onurefe/Lattice/v1.3/Hardware/Visuals/WaveUltrasonics-front.png

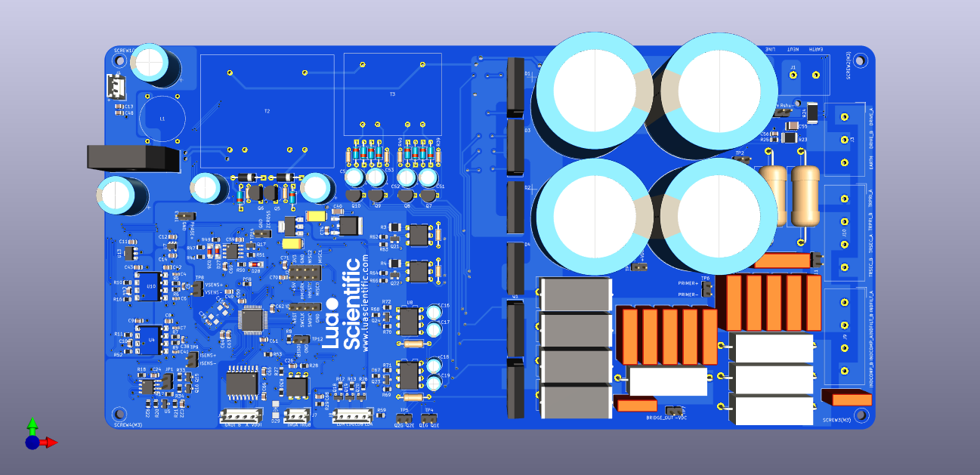
v1.3/Hardware/Visuals/WaveUltrasonics-front.png
