onurefe/Lattice/Documents/lattice.pdf

# Piezoelectric Control

Onur Efe

July 2020

## 1 Obtaining linear phase control measure

Impedance of the series rlc element can be given as;

Z = r + jwl +

1
jwc

=

jwrc − w

2
lc + 1
jwc
(1)

Since multiplicative inverse of the impedance Z is proportional to complex power, real power should be proportional to the real part of 1
Z

. According to
this normalized complex power p is introduced as;

p =

1
Z

=

jwc
jwrc − w²lc + 1
(2)

Normalized real power can be calculated as;

pr = <

jwc

(1 − w²lc) + jwrc
= <
jwc((1 − w

2
lc) − jwrc)
(1 − w²lc)

2 + (wrc)

2

= <

((jwc − jw³

lc²
) − j

2w

2

rc²
)
(1 − w²lc)

2 + (wrc)

2

=

w

2

rc²
(1 − w²lc)

2 + (wrc)

2

=

w

2

rc²
w⁴l

2c

2 − 2w²lc + w²r

2c

2 + 1

=

w

2

rc²
w⁴l

2c

2 + w²(r

2c

2 − 2lc) + 1 (3)

Expression isn’t suitable for linearization. But pimg
pr

can be a much more
suitable measure;

pimg
pr

=

wc−w

3

lc²
(1−w²lc)

2+(wrc)

2 −

1
wcp
w²rc²
(1−w²lc)

2+(wrc)

2

=

wc − w

3

lc²
w²rc²

−

(1 − w

2
lc)

2 + (wrc)

2
w³rc²cp

=

1 − w

2
lc
wrc

−

(1 − w

2
lc)

2 + (wrc)

2
w³rc²cp

(4)

1

Adding the normalized reactive power consumed by capacitance;

1 − w

2
lc −

1
wcp
wrc

(5)

Introducing quality factor which is defined defined as;

q =

1
r

r
l
c

(6)

And w0 is defined as;

w0 =

1
√
lc

(7)

Now variations of the load can be obtained from the variations of the resistance. Since the piezoelectric elements are pretty stable we can assume that l, c doesn’t change with loading; only r changes. Variables with subscript 0, 1 denoting values before and after loading respectively;

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
So when loaded, since the quality factor decreases, resistance will increase proportionally. So, in general, measuring complex impedance would give the resistance value as well; so data wheter the system is loaded or not can be obtained in very high rates.
Advantage of this method is there aren’t any dependence of any other process and control doesn’t interact with other controls.

## 2 Obtaining parallel capacitance

I = Icap + Irlc =

V
jwcp

+

jV wc
jwrc − w²lc + 1
V (jwrc − w

2
lc + 1)
(jwrc − w²lc + 1).(jwcp)

+

(jV wc).(jwcp)
(jwcp).(jwrc − w²lc + 1)

=

−V w²
ccp + V (jwrc − w

2
lc + 1)
−w²rccp − jw³lccp + jwcp

=

V (jwrc − w

2
lc + 1 − w

2
ccp)
−w²rccp − jw³lccp + jwcp

=⇒ Z =

−w

2

rccp − jw³
lccp + jwcp
jwrc − w²lc + 1 − w²ccp

(9)

Another way of obtaining the equivalent circuit model could be to use Taylor approximation applied to the impedance polynomial.

2

## 3 Power control with varying duty cycle

Components of the Fourier series of a pulse wave;

an =

2A
nπ
sin (nπd) | (10)

V, d denoting the amplitude of the pulse wave applied and duty cycle respectively, average power transmitted to the piezo device(considering that the first harmonic does match with the resonance frequency of the piezo device) does equal to;

Pdrv =

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
sin²

(πd) = 2A²
π

2r

1 − cos(2πd)
2

=

A²
π

2r

(1 − cos(2πd))

=⇒ 1 −

Pdrvπ

2
r
A²

= cos(2πd) =⇒ d =

1
2π

cos⁻¹
(1 −

Pdrvπ

2
r
A²

) (11)

Pdrvmax =

2A

2
π²r

. Now introducing normalized power Pnorm =

Pdrv
Pdrvmax

we
can express (??) as;

d =

1
2π

cos⁻¹
(1 − 2Pnorm) | (12)

Now introducing an approximation for cos⁻¹ (x);

cos⁻¹

(x) = π
2

+

x(a + bx²
)
1 + x

2(c + dx²)

(13)

where;

a
b
c
d

=

−0.939115566365855
0.9217841528914573
−1.2845906244690837
0.295624144969963174

(14)

## 4 Resonance Frequency Tracking Algorithm

Secant method like method will be used for resonance frequency tracking. Measure m =

pimg
pr

will be tried to make zero. mi

, fi denoting i.th measure and the frequency at iteration i, fi+1 is;

fi+1 = fi −

mi(fi − fi−1)

mi − mi−1

(15)

There should be some error about frequency shifting.

3
