onurefe/Lattice/v1.3/Hardware/Visuals/WaveUltrasonics-back.png

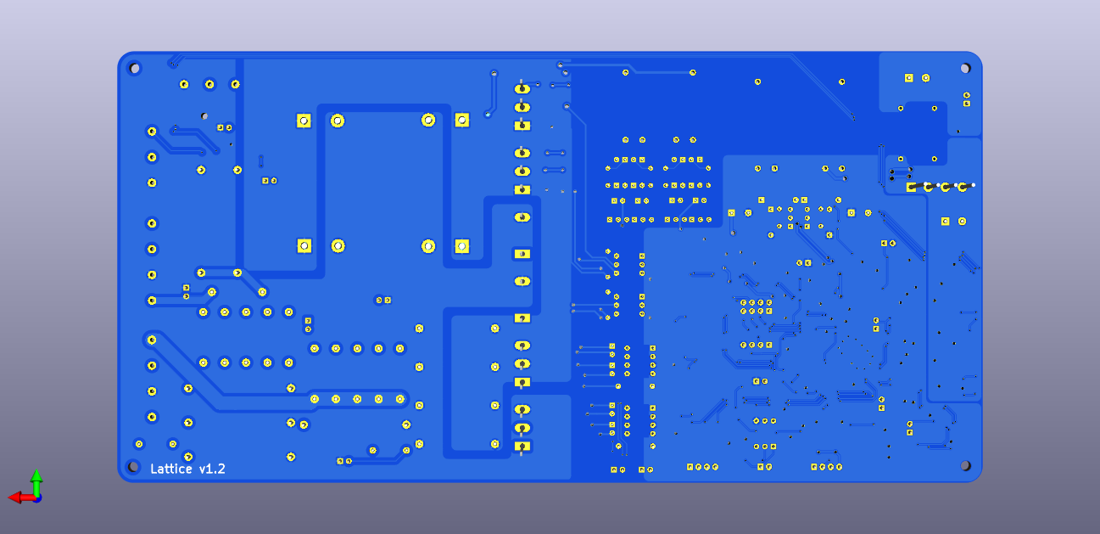
v1.3/Hardware/Visuals/WaveUltrasonics-back.png
