onurefe/Lattice/v1.3/Hardware/BOM v1.3.xlsx

Component(s) | Value | Link | Price | Quantity
> C1-C3, C69 | 470u 400v | https://ozdisan.com/passive-components/capacitors/aluminum-capacitors/K054004710PM0E050 | 3.43 USD | 4 | 13.73 USD
> C5, C38 | 33n %5 | https://ozdisan.com/passive-components/capacitors/smt-smd-and-mlcc-capacitors/CL21B333JBANNNC | 0.03 USD | 2 | 0.05 USD
> C4, C6, C7, C41 | 1n %5 | https://ozdisan.com/passive-components/capacitors/smt-smd-and-mlcc-capacitors/CL21C102JBCNNNC | 0.02 USD | 4 | 0.06 USD
> C11, C12, C14, C63 | 1u | https://ozdisan.com/passive-components/capacitors/smt-smd-and-mlcc-capacitors/CL21B105KBFNNNE | 0.02 USD | 4 | 0.09 USD
> C16-C19 | 2.2u 50v | https://ozdisan.com/passive-components/capacitors/smt-smd-and-mlcc-capacitors/CL21A225KBQNNNE | 0.06 USD | 4 | 0.24 USD
> C20, C21, C36, C37 | 820n 400VDC | https://ozdisan.com/passive-components/capacitors/film-capacitors/TMCF03-824K400VP22-5B | 0.11 USD | 4 | 0.44 USD
C23 | 1.5n 400VAC | https://ozdisan.com/passive-components/capacitors/film-capacitors/C323C152J60A605 | 0.12 USD | 1 | 0.12 USD
> C27, C29, C31 | 10nF 1600VDC | https://ozdisan.com/passive-components/capacitors/film-capacitors/C323C103J60A605 | 0.17 USD | 3 | 0.50 USD
> C22, C28, C30 | 22nF 2000VDC | https://ozdisan.com/passive-components/capacitors/film-capacitors/C84V1223J90C000 | 0.51 USD | 3 | 1.54 USD
C35 | 1000u 25v | https://ozdisan.com/passive-components/capacitors/aluminum-capacitors/PKR1-025V102MG160-TA5-0 | 0.09 USD | 1 | 0.09 USD
> C15, C39 | 18p | https://ozdisan.com/passive-components/capacitors/smt-smd-and-mlcc-capacitors/CL10C180JB8NNNC | 0.01 USD | 2 | 0.01 USD
C40 | 1uF 35v | https://ozdisan.com/passive-components/capacitors/tantalum-capacitors/T491A105K035AT | 0.10 USD | 1 | 0.10 USD
> C8, C9, C13, C24, C26, C32-C34, C42, C43, C49, C50, C61, C62, C64, C65, C68, C74 | 100n | https://ozdisan.com/passive-components/capacitors/smt-smd-and-mlcc-capacitors/CL21B104KBFWPNE | 0.02 USD | 18 | 0.28 USD
> C10, C44 | 47n %5 | https://ozdisan.com/passive-components/capacitors/smt-smd-and-mlcc-capacitors/CL31B473JBCNNNC | 0.04 USD | 2 | 0.08 USD
C47 | 2200u 25v | https://ozdisan.com/passive-components/capacitors/aluminum-capacitors/PKLH-025V222MI220-TA5-0 | 0.26 USD | 1 | 0.26 USD
> C51-C54 | 220u | https://ozdisan.com/passive-components/capacitors/aluminum-capacitors/PKR1-025V221ME110-T2-5 | 0.03 USD | 4 | 0.11 USD
C55 | 100p | https://ozdisan.com/passive-components/capacitors/smt-smd-and-mlcc-capacitors/C1210C101KGRAC7800 | 0.31 USD | 1 | 0.31 USD
C56 | 680n | https://ozdisan.com/passive-components/capacitors/smt-smd-and-mlcc-capacitors/CL21B684KOFNNNE | 0.03 USD | 1 | 0.03 USD
> C25, C73 | 1.5n 1600VDC | https://ozdisan.com/passive-components/capacitors/film-capacitors/C323C152J60A605 | 0.12 USD | 2 | 0.24 USD
> C67, C75 | 10uF | https://ozdisan.com/passive-components/capacitors/tantalum-capacitors/T491C106K025AT | 0.25 USD | 2 | 0.50 USD
> D1-D4 | DSEI60-06A | https://ozdisan.com/Product/Detail/2822/DSEI60-06A | 3.15 USD | 4 | 12.60 USD
> D5, D6, D10-D13 | M7-KT | https://ozdisan.com/power-semiconductors/diodes-diode-modules-and-rectifiers/general-purpose-diodes/M7-KT | 0.01 USD | 6 | 0.07 USD
D7 | D_Bridge_+AA- | https://www.ozdisan.com/power-semiconductors/diodes-diode-modules-and-rectifiers/bridge-diodes/FL4010B010001 | 0.29 USD | 1 | 0.29 USD
> D18-D21 | 15v | https://ozdisan.com/power-semiconductors/diodes-diode-modules-and-rectifiers/zener-diodes/MMSZ15V-HT | 0.03 USD | 4 | 0.11 USD
D29 | SMAJ6R0CA-HT | https://ozdisan.com/power-semiconductors/diodes-diode-modules-and-rectifiers/tvs-diodes/SMAJ6R0CA-HT | 0.10 USD | 1 | 0.10 USD
> J1, J3, J4 | DG25C-B-03P-13-00AH | https://ozdisan.com/connectors-and-interconnects/terminal-blocks/barrier-terminal-blocks/DG25C-B-03P-13-00AH | 0.28 USD | 3 | 0.83 USD
J2 | Conn_01x05 | https://ozdisan.com/connectors-and-interconnects/headers/pin-headers/DS1021-1X5SF11-B | 0.02 USD | 1 | 0.02 USD
J5 | Conn_01x08 | https://ozdisan.com/connectors-and-interconnects/headers/pin-headers/L-KLS1-207-1-08-S | 0.04 USD | 1 | 0.04 USD
> J6, J7 | DS1069-02MVW6X | https://ozdisan.com/connectors-and-interconnects/rectangular-connectors/pcb-connectors/DS1069-02MVW6X | 0.01 USD | 2 | 0.01 USD
J8 | DS1069-04MVW6X | https://ozdisan.com/Product/Detail/347998/DS1069-04MVW6X | 0.01 USD | 1 | 0.01 USD
J10 | DG25C-B-04P-13-00AH | https://ozdisan.com/Product/Detail/442582/DG25C-B-04P-13-00AH | 0.41 USD | 1 | 0.41 USD
> Q1, Q2 | IXGH48N60C3D1 | https://www.ozdisan.com/power-semiconductors/igbts/discrete-igbts/IXGH48N60C3D1 | 3.94 USD | 2 | 7.88 USD
Q3 | BC817-40 | https://ozdisan.com/power-semiconductors/transistors/discrete-transistors/BC817-40215 | 0.02 USD | 1 | 0.02 USD
> Q7, Q9 | BC847C | https://ozdisan.com/power-semiconductors/transistors/discrete-transistors/BC847C215 | 0.02 USD | 2 | 0.03 USD
> Q8, Q10 | BC857C | https://ozdisan.com/power-semiconductors/transistors/discrete-transistors/BC857C215 | 0.02 USD | 2 | 0.03 USD
> Q18-Q20, Q23, Q24 | MMBT3904 | https://ozdisan.com/Product/Detail/451907/MMBT3904LT1G | 0.01 USD | 5 | 0.06 USD
R1 | 100R 5W | https://ozdisan.com/passive-components/resistors/tht-through-hole-resistors/MOR05WJ0101B00 | 0.17 USD | 1 | 0.17 USD
R2 | 1k | https://ozdisan.com/passive-components/resistors/smt-smd-and-chip-resistors/0805S8J0102T5E | 0.00221 USD | 1 | 0.00221 USD
> R3, R11 | 10R %1 | https://ozdisan.com/passive-components/resistors/smt-smd-and-chip-resistors/TC0550F100JT5F | 0.03 USD | 2 | 0.05 USD
> R5-R7, R9 | 33R %1 | https://ozdisan.com/passive-components/resistors/smt-smd-and-chip-resistors/0805S8F330JT5E | 0.00286 USD | 4 | 0.01 USD
> R12, R13, R26, R58 | 10k | https://ozdisan.com/passive-components/resistors/smt-smd-and-chip-resistors/0805S8J0103T5E | 0.00221 USD | 4 | 0.01 USD
> R14, R15 | 8.2R | https://ozdisan.com/passive-components/resistors/smt-smd-and-chip-resistors/1206S4J082JT5E | 0.00364 USD | 2 | 0.01 USD
> R16, R52 | 0R | https://ozdisan.com/passive-components/resistors/smt-smd-and-chip-resistors/0805S8J0000T5E | 0.00221 USD | 2 | 0.00442 USD
> R8, R17, R18, R20 | 1k %0.1 | https://ozdisan.com/passive-components/resistors/smt-smd-and-chip-resistors/0805S8F1001T5E | 0.00286 USD | 4 | 0.01 USD
R19 | 22R 5W | https://ozdisan.com/passive-components/resistors/tht-through-hole-resistors/MOR05SJ0220B07 | 0.16 USD | 1 | 0.16 USD
> R21, R22, R31, R32 | 3.3k %0.1 | https://ozdisan.com/passive-components/resistors/smt-smd-and-chip-resistors/TC0525B3301T5F | 0.09 USD | 4 | 0.36 USD
R23 | 2.2M 0.5W %1 | https://ozdisan.com/passive-components/resistors/smt-smd-and-chip-resistors/1812W2F2204T4E | 0.05 USD | 1 | 0.05 USD
R24 | 10mohm 4W %1 | https://ozdisan.com/passive-components/resistors/precision-power-and-shunt-resistors/VMS-R010-1-0 | 0.93 USD | 1 | 0.93 USD
R25 | 324R %1 | https://ozdisan.com/passive-components/resistors/smt-smd-and-chip-resistors/0805S8F3240T5E | 0.00286 USD | 1 | 0.00286 USD
> R28, R69, R70 | 4.7k | https://ozdisan.com/passive-components/resistors/smt-smd-and-chip-resistors/0805S8F4701T5E | 0.00286 USD | 3 | 0.01 USD
> R29, R30 | 220R | https://ozdisan.com/passive-components/resistors/smt-smd-and-chip-resistors/0805S8J0221T5E | 0.00221 USD | 2 | 0.00442 USD
R59 | 470R | https://ozdisan.com/passive-components/resistors/smt-smd-and-chip-resistors/0805S8J0471T5E | 0.00221 USD | 1 | 0.00221 USD
> R39-R42, R67, R68 | 1k | https://ozdisan.com/passive-components/resistors/smt-smd-and-chip-resistors/0805S8J0102T5E | 0.00221 USD | 6 | 0.01 USD
> R71, R72 | 120R | https://ozdisan.com/passive-components/resistors/smt-smd-and-chip-resistors/HP05W3F1200T5E | 0.01 USD | 2 | 0.01 USD
> R73, R74 | 22k 7W | https://ozdisan.com/passive-components/resistors/tht-through-hole-resistors/MOR07SJ0223B00 | 0.20 USD | 2 | 0.39 USD
> R76, R77 | 6.8k 7W | https://ozdisan.com/passive-components/resistors/tht-through-hole-resistors/MOR07SJ0682B00 | 0.20 USD | 2 | 0.39 USD
T1 | ASL151212 | https://ozdisan.com/passive-components/transformers/general-type-transformers/ASL151212 | 5.14 USD | 1 | 5.14 USD
T3 | Transformer_1P_2S | https://ozdisan.com/passive-components/transformers/general-type-transformers/ASL102212 | 2.43 USD | 1 | 2.43 USD
> TP1-TP9, TP11 | TestPoint_2Pole | https://ozdisan.com/connectors-and-interconnects/headers/pin-headers/DS1021-1X2SF11-B | 0.01 USD | 10 | 0.13 USD
U1 | ALZN5B12W | https://ozdisan.com/electromechanical-components/relays-and-relay-sockets/general-type-relays/ALZN5B12W | 1.12 USD | 1 | 1.12 USD
U2 | MAX3485 | https://ozdisan.com/integrated-circuits-ics/interfaces-and-peripherals-ics/drivers-receivers-and-transceivers/MAX3485EESAT | 1.85 USD | 1 | 1.85 USD
U3 | MCP6024 | https://ozdisan.com/integrated-circuits-ics/linear-ics/amplifiers/MCP6024-ISL | 1.68 USD | 1 | 1.68 USD
> U4, U10 | ACPL-7900 | https://ozdisan.com/Product/Detail/459212/ACPL-7900-500E | 5.40 USD | 2 | 10.80 USD
U6 | L7805 | https://ozdisan.com/integrated-circuits-ics/power-management-ics/linear-voltage-regulators/MC7805CDTG | 0.55 USD | 1 | 0.55 USD
U7 | TLV73333PDBV | https://ozdisan.com/integrated-circuits-ics/power-management-ics/linear-voltage-regulators/TLV73333PDBVR | 0.10 USD | 1 | 0.10 USD
> U8, U9 | HCPL-3120 | https://ozdisan.com/optoelectronics-and-sensors/optoelectronics/optocoupler-gate-drivers/HCPL-3120-000E | 1.77 USD | 2 | 3.55 USD
U13 | L78L05_SOT89 | https://ozdisan.com/integrated-circuits-ics/power-management-ics/linear-voltage-regulators/L78L05ABUTR-HT | 0.05 USD | 1 | 0.05 USD
U14 | TLV1117-33 | https://ozdisan.com/integrated-circuits-ics/power-management-ics/linear-voltage-regulators/TLV1117-33IDCYR | 0.43 USD | 1 | 0.43 USD
U15 | 4N25 | https://ozdisan.com/optoelectronics-and-sensors/optoelectronics/optocoupler-transistor-output/4N25-LITEON | 0.26 USD | 1 | 0.26 USD
U17 | STM32F334C8Tx | https://ozdisan.com/Product/Detail/493492/STM32F334C8T6 | 7.16 USD | 1 | 7.16 USD
Y1 | 8MHz | https://ozdisan.com/passive-components/crystals-oscillators-and-resonators/crystals/H130B-8-000-16-3030-TR | 0.50 USD | 1 | 0.50 USD
Total cost | 79.66 USD
