onurefe/Lattice/Documents/Measure plot Q=50.png

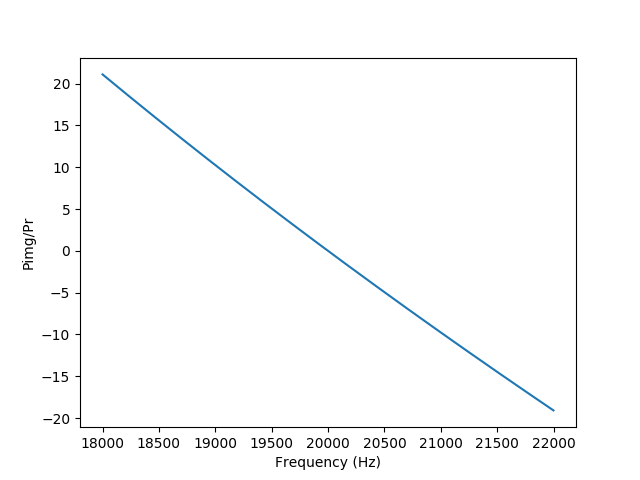
Documents/Measure plot Q=50.png
