onurefe/Lattice/PSpice/WaveUltrasonicOutputStage - Peaking.asc

C1: cap; 47n
C2: cap; 220n
L1: ind; 240e-6
V1: signal; PULSE(-310 310 0 500n 500n 25u 50u); AC 310
Named nets: 0
.ac dec 100000 1e3 1e5
