onurefe/Lattice/PSpice/WaveUltrasonicOutputStage-v1.2.asc

C1: cap; 30n
C2: cap; 66n
C3: cap; 20e-9
C5: cap; 1.5n
C6: cap; 2.2n
L1: ind; 1e-3
L2: ind2; 0.002
L3: ind2; 0.008
R1: res; 10k
R3: res; 2.2k
R4: res; 10m
V1: signal; PULSE(-140 140 0 1.5u 1.5u 25.526315789473685u 52.63157894736842u); AC 140
Named nets: 0
.ac dec 10000 19000 72000
K1 L2 L3 0.99
