onurefe/Lattice/v1.3/Hardware/WaveUltrasonics.kicad_pcb

## KiCad design v1.3/Hardware/WaveUltrasonics.kicad_pcb (2020-10-29)

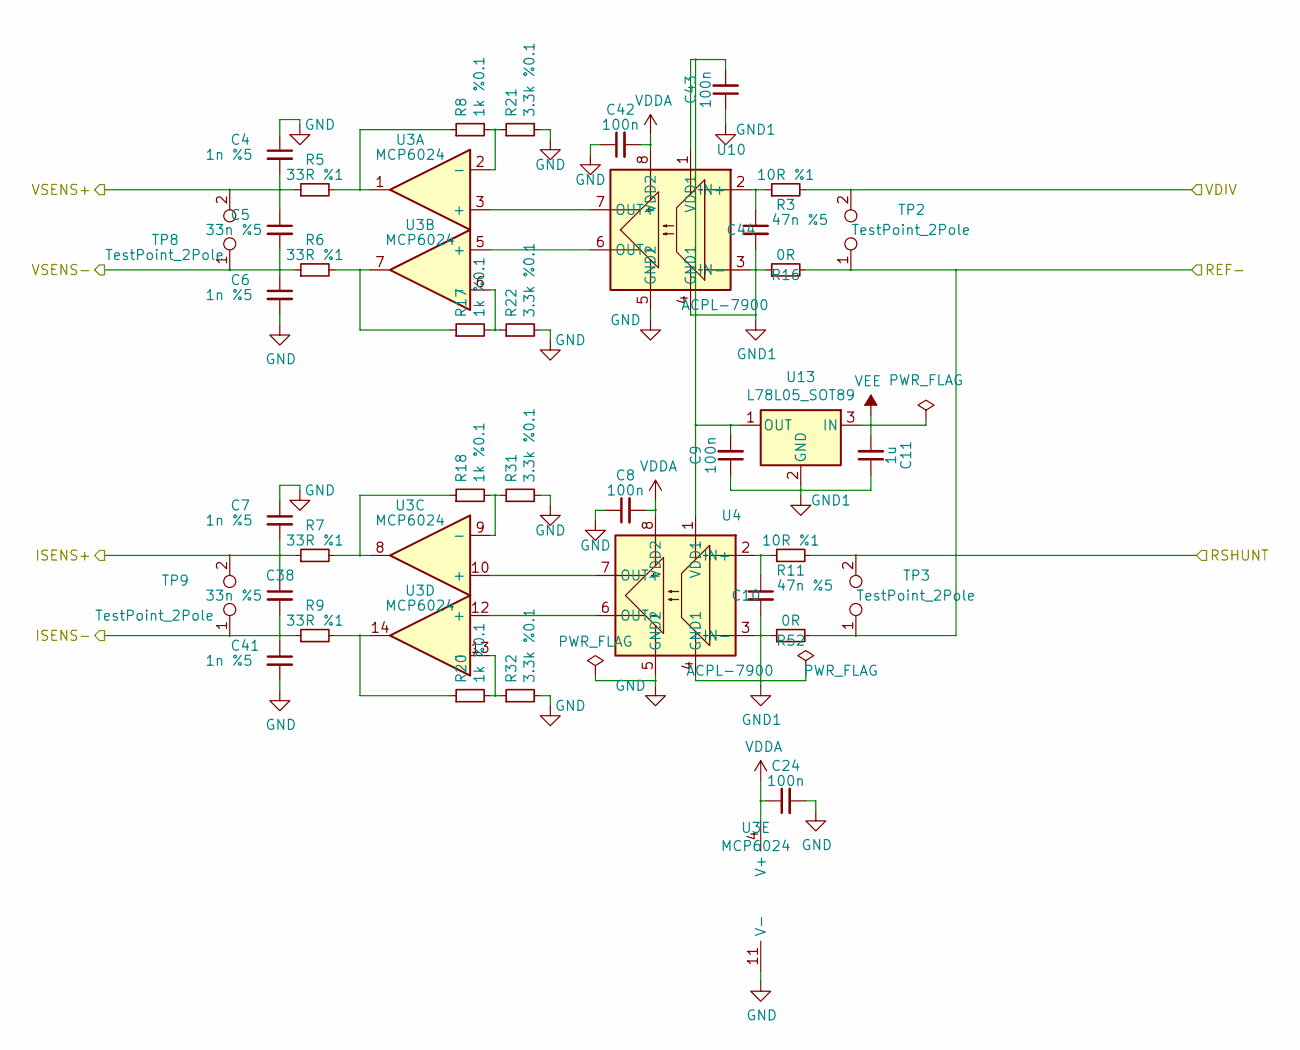
[picture p4: schematic Afe.kicad_sch]

Parts:
C4, C6, C7, C41: 1n %5; C_0805_2012Metric
C5, C38: 33n %5; C_0805_2012Metric
C8, C9, C24, C42, C43: 100n; C_0805_2012Metric
C10, C44: 47n %5; C_1206_3216Metric
C11: 1u; C_0805_2012Metric
R3, R11: 10R %1; R_0805_2012Metric
R5, R6, R7, R9: 33R %1; R_0805_2012Metric
R8, R17, R18, R20: 1k %0.1; R_0805_2012Metric
R16, R52: 0R; R_0805_2012Metric
R21, R22, R31, R32: 3.3k %0.1; R_0805_2012Metric
TP2, TP3, TP8, TP9: TestPoint_2Pole; PinHeader_1x02_P2.54mm_Vertical
U3: MCP6024; SOIC-14_3.9x8.7mm_P1.27mm
U4, U10: ACPL-7900; SSO-8_6.7x9.8mm_P2.54mm_Clearance8mm
U13: L78L05_SOT89; SOT-89-3

Connections:
/ISENS+: C7.2, C38.1, R7.1, TP9.2; also elsewhere on the board
/ISENS-: C38.2, C41.1, R9.1, TP9.1; also elsewhere on the board
/RSHUNT: R11.2, TP3.2; also elsewhere on the board
/VDIV: R3.2, TP2.2; also elsewhere on the board
/VSENS+: C4.2, C5.1, R5.1, TP8.2; also elsewhere on the board
/VSENS-: C5.2, C6.1, R6.1, TP8.1; also elsewhere on the board
Earth_Protective: R16.2, R52.2, TP2.1, TP3.1; also elsewhere on the board
GND: C4.1, C6.2, C7.1, C8.1, C24.2, C41.2, C42.1, R21.2, R22.2, R31.2, R32.2, U3.11 (V-), U4.5 (GND2), U10.5 (GND2); also elsewhere on the board
GND1: C9.1, C10.2, C11.1, C43.1, C44.2, R16.1, R52.1, U4.3 (IN-), U4.4 (GND1), U10.3 (IN-), U10.4 (GND1), U13.2 (GND); also elsewhere on the board
unnamed: C10.1, R11.1, U4.2 (IN+)
unnamed: C9.2, C43.2, U4.1 (VDD1), U10.1 (VDD1), U13.1 (OUT)
unnamed: C44.1, R3.1, U10.2 (IN+)
unnamed: R5.2, R8.1, U3.1
unnamed: R6.2, R17.1, U3.7
unnamed: R17.2, R22.1, U3.6 (-)
unnamed: R7.2, R18.1, U3.8
unnamed: R18.2, R31.1, U3.9 (-)
unnamed: R9.2, R20.1, U3.14
unnamed: R20.2, R32.1, U3.13 (-)
unnamed: R8.2, R21.1, U3.2 (-)
unnamed: U3.10 (+), U4.7 (OUT+)
unnamed: U3.12 (+), U4.6 (OUT-)
unnamed: U3.5 (+), U10.6 (OUT-)
unnamed: U3.3 (+), U10.7 (OUT+)
VDDA: C8.2, C24.1, C42.2, U3.4 (V+), U4.8 (VDD2), U10.8 (VDD2); also elsewhere on the board
VEE: C11.2, U13.3 (IN); also elsewhere on the board

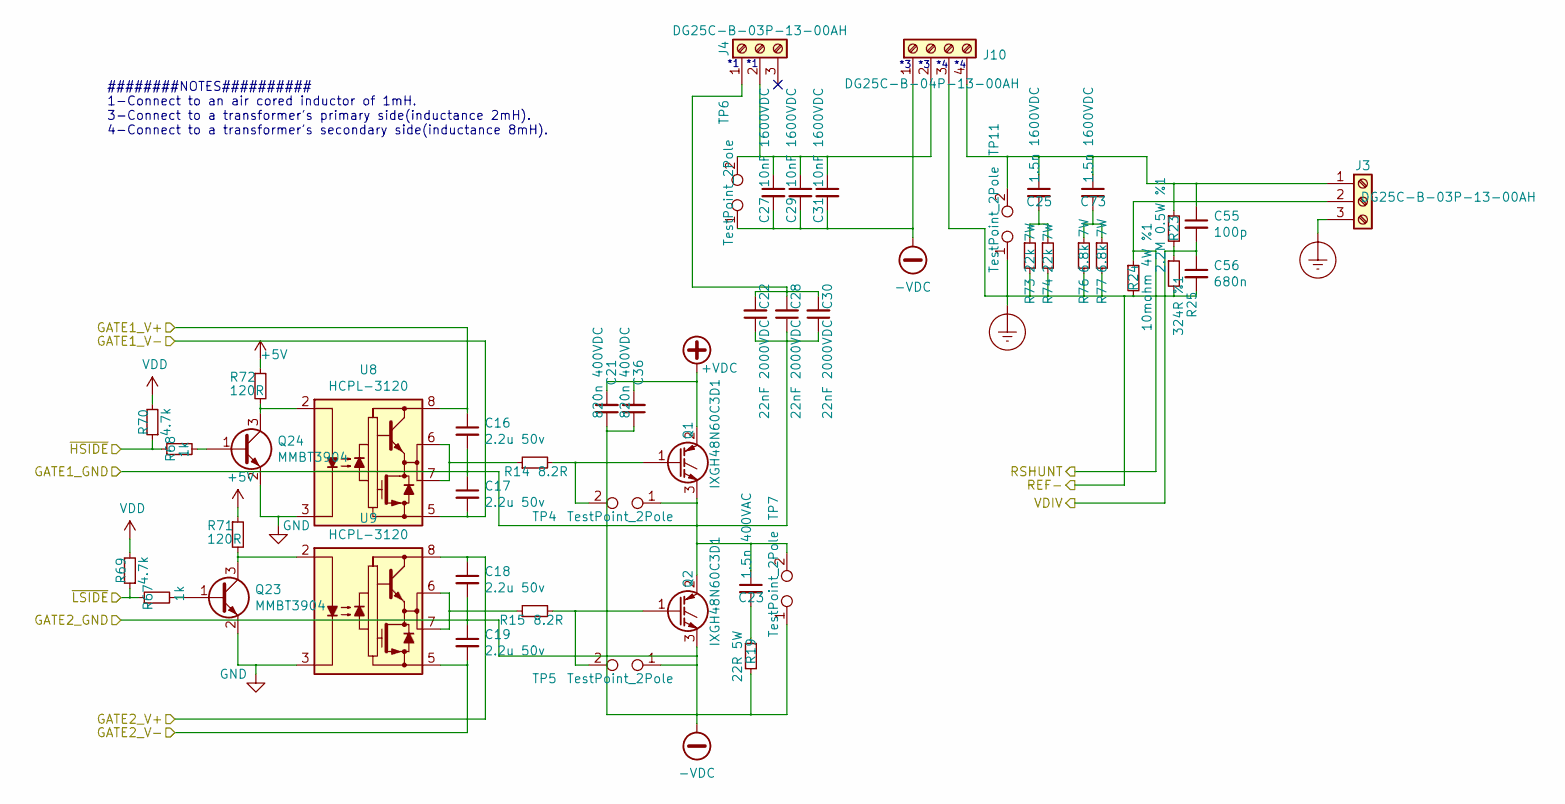
[picture p5: schematic HalfBridge.kicad_sch]

Parts:
C16, C17, C18, C19: 2.2u 50v; C_0805_2012Metric
C21, C36: 820n 400VDC; C_Rect_L24.0mm_W10.1mm_P22.50mm_MKT
C22, C28, C30: 22nF 2000VDC; C_Rect_L26.5mm_W10.5mm_P22.50mm_MKS4
C23: 1.5n 400VAC; C_Rect_L18.0mm_W5.0mm_P15.00mm_FKS3_FKP3
C25, C73: 1.5n 1600VDC; C_Rect_L18.0mm_W5.0mm_P15.00mm_FKS3_FKP3
C27, C29, C31: 10nF 1600VDC; C_Rect_L18.0mm_W6.0mm_P15.00mm_FKS3_FKP3
C55: 100p; C_1210_3225Metric
C56: 680n; C_0805_2012Metric
J3, J4: DG25C-B-03P-13-00AH
J10: DG25C-B-04P-13-00AH
Q1, Q2: IXGH48N60C3D1; TO-247-3_Vertical
Q23, Q24: MMBT3904; SOT-23
R14, R15: 8.2R; R_1206_3216Metric
R19: 22R 5W; R_Axial_Power_L25.0mm_W9.0mm_P30.48mm
R23: 2.2M 0.5W %1; R_1812_4532Metric
R24: 10mohm 4W %1; R_2512_6332Metric
R25: 324R %1; R_0805_2012Metric
R67, R68: 1k; R_0805_2012Metric
R69, R70: 4.7k; R_0805_2012Metric
R71, R72: 120R; R_0805_2012Metric
R73, R74: 22k 7W; R_Axial_DIN0922_L20.0mm_D9.0mm_P30.48mm_Horizontal
R76, R77: 6.8k 7W; R_Axial_Power_L25.0mm_W9.0mm_P30.48mm
TP4, TP5, TP6, TP7, TP11: TestPoint_2Pole; PinHeader_1x02_P2.54mm_Vertical
U8, U9: HCPL-3120; DIP-8_W7.62mm

Connections:
+5V: R71.1, R72.1; also elsewhere on the board
+VDC: C21.2, C36.2, Q1.2 (C); also elsewhere on the board
-VDC: C18.2, C19.1, C21.1, C27.2, C29.2, C31.2, C36.1, J10.1, Q2.3 (E), R19.2, TP5.1, TP6.1, TP7.1; also elsewhere on the board
/GATE1_GND: C16.2, C17.1, C22.1, C23.1, C28.1, C30.1, Q1.3 (E), Q2.2 (C), TP4.1, TP7.2; also elsewhere on the board
/GATE1_V+: C16.1, U8.8 (VCC); also elsewhere on the board
/GATE1_V-: C17.2, U8.5 (VEE); also elsewhere on the board
/GATE2_V+: C18.1, U9.8 (VCC); also elsewhere on the board
/GATE2_V-: C19.2, U9.5 (VEE); also elsewhere on the board
/RSHUNT: J3.2, R24.1; also elsewhere on the board
/VDIV: C55.2, C56.1, R23.2, R25.1; also elsewhere on the board
/~HALFBRIDGE_HSIDE: R68.1, R70.1; also elsewhere on the board
/~HALFBRIDGE_LSIDE: R67.1, R69.1; also elsewhere on the board
Earth_Protective: C56.2, J3.3, J10.3, R24.2, R25.2, R73.2, R74.2, R76.2, R77.2, TP11.1; also elsewhere on the board
GND: Q23.2 (E), Q24.2 (E), U8.3 (C), U9.3 (C); also elsewhere on the board
unnamed: C22.2, C28.2, C30.2, J4.1
unnamed: C23.2, R19.1
unnamed: C25.1, C55.1, C73.1, J3.1, J10.4, R23.1, TP11.2
unnamed: C25.2, R73.1, R74.1
unnamed: C27.1, C29.1, C31.1, J4.2, J10.2, TP6.2
unnamed: C73.2, R76.1, R77.1
unnamed: Q1.1 (G), R14.2, TP4.2
unnamed: Q2.1 (G), R15.2, TP5.2
unnamed: Q23.1 (B), R67.2
unnamed: Q23.3 (C), R71.2, U9.2 (A)
unnamed: Q24.1 (B), R68.2
unnamed: Q24.3 (C), R72.2, U8.2 (A)
unnamed: R14.1, U8.6 (VO), U8.7 (VO)
unnamed: R15.1, U9.6 (VO), U9.7 (VO)
VDD: R69.2, R70.2; also elsewhere on the board

Notes on the sheet:
########NOTES########## 1-Connect to an air cored inductor of 1mH. 3-Connect to a transformer's primary side(inductance 2mH). 4-Connect to a transformer's secondary side(inductance 8mH).

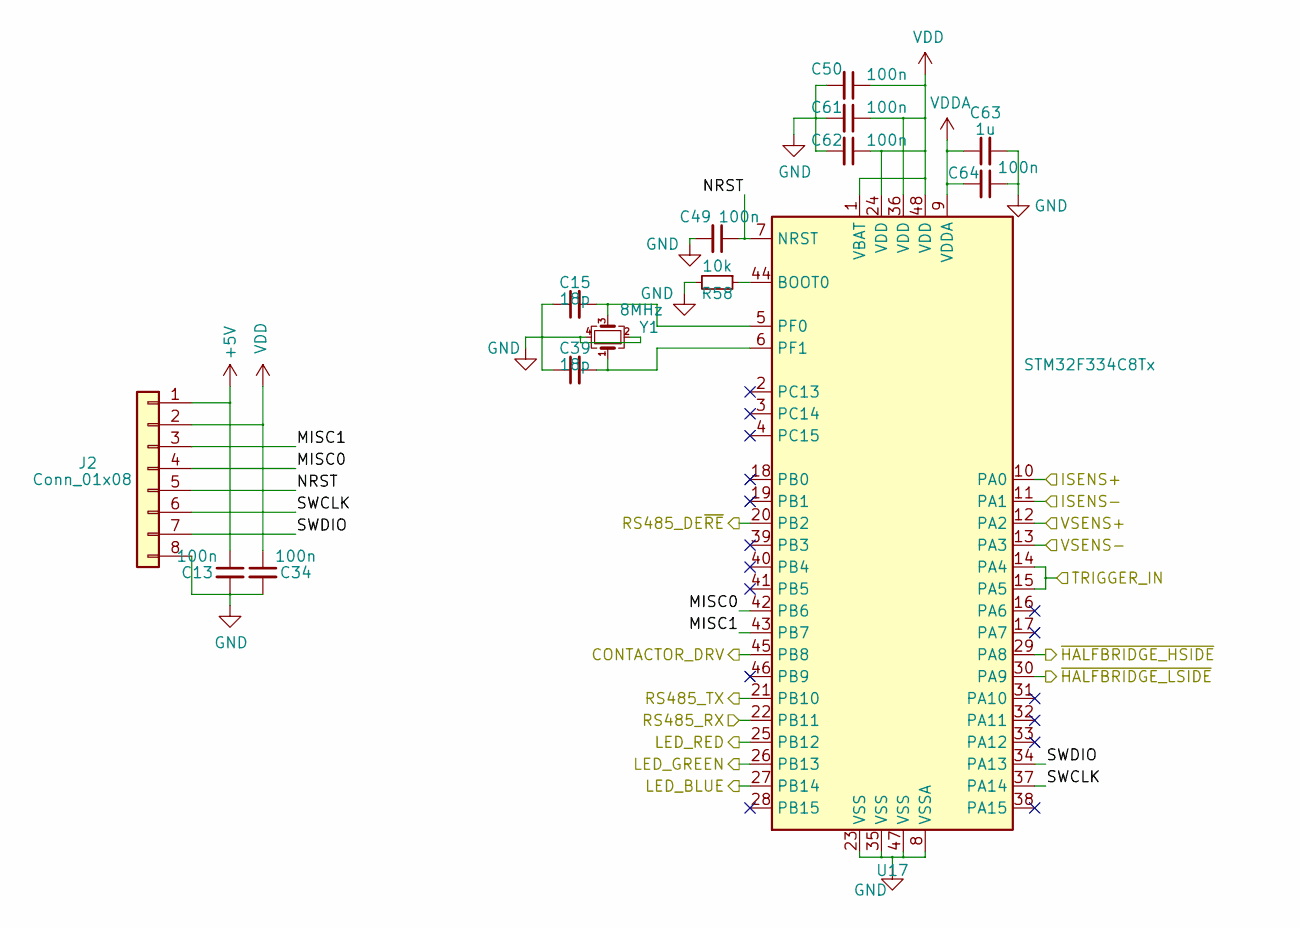
[picture p6: schematic Mcu.kicad_sch]

Parts:
C13, C34, C49, C50, C61, C62, C64: 100n; C_0805_2012Metric
C15, C39: 18p; C_0603_1608Metric
C63: 1u; C_0805_2012Metric
J2: Conn_01x08; PinHeader_1x08_P2.54mm_Vertical
R58: 10k; R_0805_2012Metric
U17: STM32F334C8Tx; LQFP-48_7x7mm_P0.5mm
Y1: 8MHz; Crystal_5x3.2mm_4leads

Connections:
+5V: C13.1, J2.1; also elsewhere on the board
/CONTACTOR_DRV: U17.45 (PB8); also elsewhere on the board
/ISENS+: U17.10 (PA0); also elsewhere on the board
/ISENS-: U17.11 (PA1); also elsewhere on the board
/LED_BLUE: U17.27 (PB14); also elsewhere on the board
/LED_GREEN: U17.26 (PB13); also elsewhere on the board
/LED_RED: U17.25 (PB12); also elsewhere on the board
/Mcu/MISC0: J2.4, U17.42 (PB6)
/Mcu/MISC1: J2.3, U17.43 (PB7)
/Mcu/NRST: C49.1, J2.5, U17.7 (NRST)
/Mcu/SWCLK: J2.6, U17.37 (PA14)
/Mcu/SWDIO: J2.7, U17.34 (PA13)
/RS485_DE~RE: U17.20 (PB2); also elsewhere on the board
/RS485_RX: U17.22 (PB11); also elsewhere on the board
/RS485_TX: U17.21 (PB10); also elsewhere on the board
/TRIGOUT: U17.14 (PA4), U17.15 (PA5); also elsewhere on the board
/VSENS+: U17.12 (PA2); also elsewhere on the board
/VSENS-: U17.13 (PA3); also elsewhere on the board
/~HALFBRIDGE_HSIDE: U17.29 (PA8); also elsewhere on the board
/~HALFBRIDGE_LSIDE: U17.30 (PA9); also elsewhere on the board
GND: C13.2, C15.1, C34.2, C39.1, C49.2, C50.2, C61.2, C62.2, C63.2, C64.1, J2.8, R58.2, U17.8 (VSSA), U17.23 (VSS), U17.35 (VSS), U17.47 (VSS), Y1.2, Y1.4; also elsewhere on the board
unnamed: C15.2, U17.5 (PF0), Y1.3
unnamed: C39.2, U17.6 (PF1), Y1.1
unnamed: R58.1, U17.44 (BOOT0)
VDD: C34.1, C50.1, C61.1, C62.1, J2.2, U17.1 (VBAT), U17.24 (VDD), U17.36 (VDD), U17.48 (VDD); also elsewhere on the board
VDDA: C63.1, C64.2, U17.9 (VDDA); also elsewhere on the board

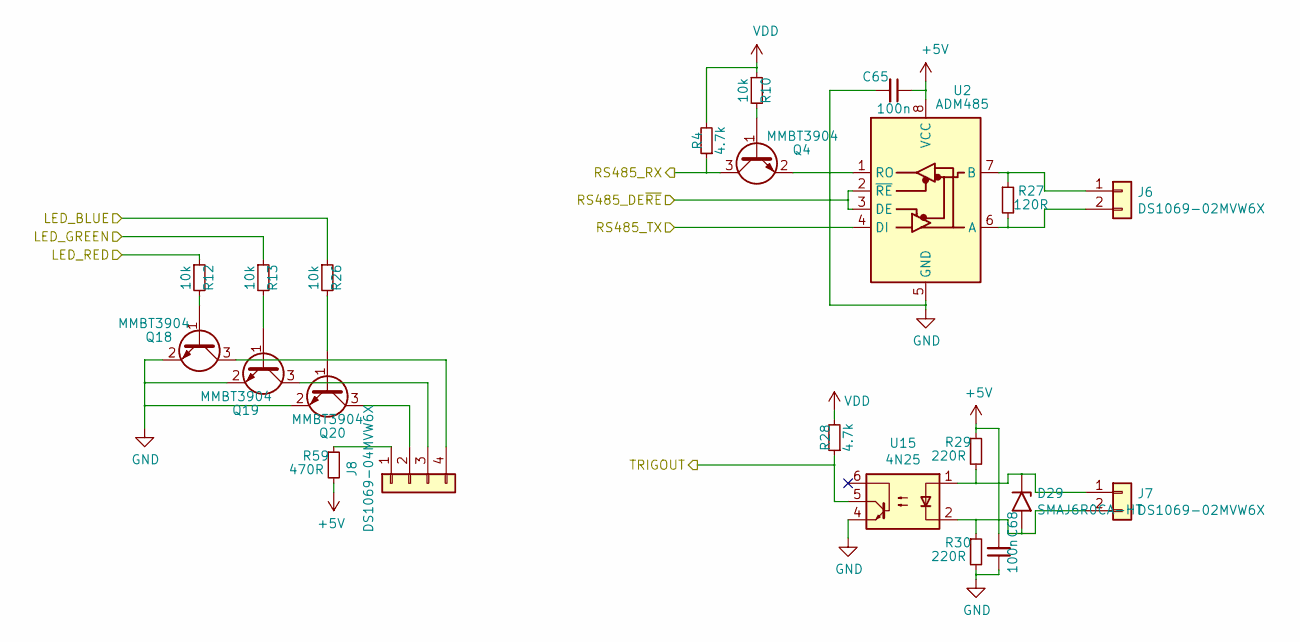
[picture p7: schematic Misc.kicad_sch]

Parts:
C65, C68: 100n; C_0805_2012Metric
D29: SMAJ6R0CA-HT; DO214AC_SMA
J6, J7: DS1069-02MVW6X; JST_EH_B2B-EH-A_1x02_P2.50mm_Vertical
J8: DS1069-04MVW6X; JST_EH_B4B-EH-A_1x04_P2.50mm_Vertical
Q4, Q18, Q19, Q20: MMBT3904; SOT-23
R4, R28: 4.7k; R_0805_2012Metric
R10, R12, R13, R26: 10k; R_0805_2012Metric
R27: 120R; R_0805_2012Metric
R29, R30: 220R; R_0805_2012Metric
R59: 470R; R_0805_2012Metric
U2: ADM485; SOIC-8_3.9x4.9mm_P1.27mm
U15: 4N25; DIP-6_W7.62mm

Connections:
+5V: C65.1, C68.2, R29.1, R59.2, U2.8 (VCC); also elsewhere on the board
/LED_BLUE: R26.1; also elsewhere on the board
/LED_GREEN: R13.1; also elsewhere on the board
/LED_RED: R12.1; also elsewhere on the board
/RS485_DE~RE: U2.2 (~RE), U2.3 (DE); also elsewhere on the board
/RS485_RX: Q4.3 (C), R4.1; also elsewhere on the board
/RS485_TX: U2.4 (DI); also elsewhere on the board
/TRIGOUT: R28.1, U15.5; also elsewhere on the board
GND: C65.2, C68.1, Q18.2 (E), Q19.2 (E), Q20.2 (E), R30.2, U2.5 (GND), U15.4; also elsewhere on the board
unnamed: D29.1 (A1), J7.1, R29.2, U15.1
unnamed: D29.2 (A2), J7.2, R30.1, U15.2
unnamed: J6.1, R27.1, U2.7 (B)
unnamed: J6.2, R27.2, U2.6 (A)
unnamed: J8.1, R59.1
unnamed: J8.2, Q20.3 (C)
unnamed: J8.3, Q19.3 (C)
unnamed: J8.4, Q18.3 (C)
unnamed: Q4.1 (B), R10.2
unnamed: Q4.2 (E), U2.1 (RO)
unnamed: Q18.1 (B), R12.2
unnamed: Q19.1 (B), R13.2
unnamed: Q20.1 (B), R26.2
VDD: R4.2, R10.1, R28.2; also elsewhere on the board

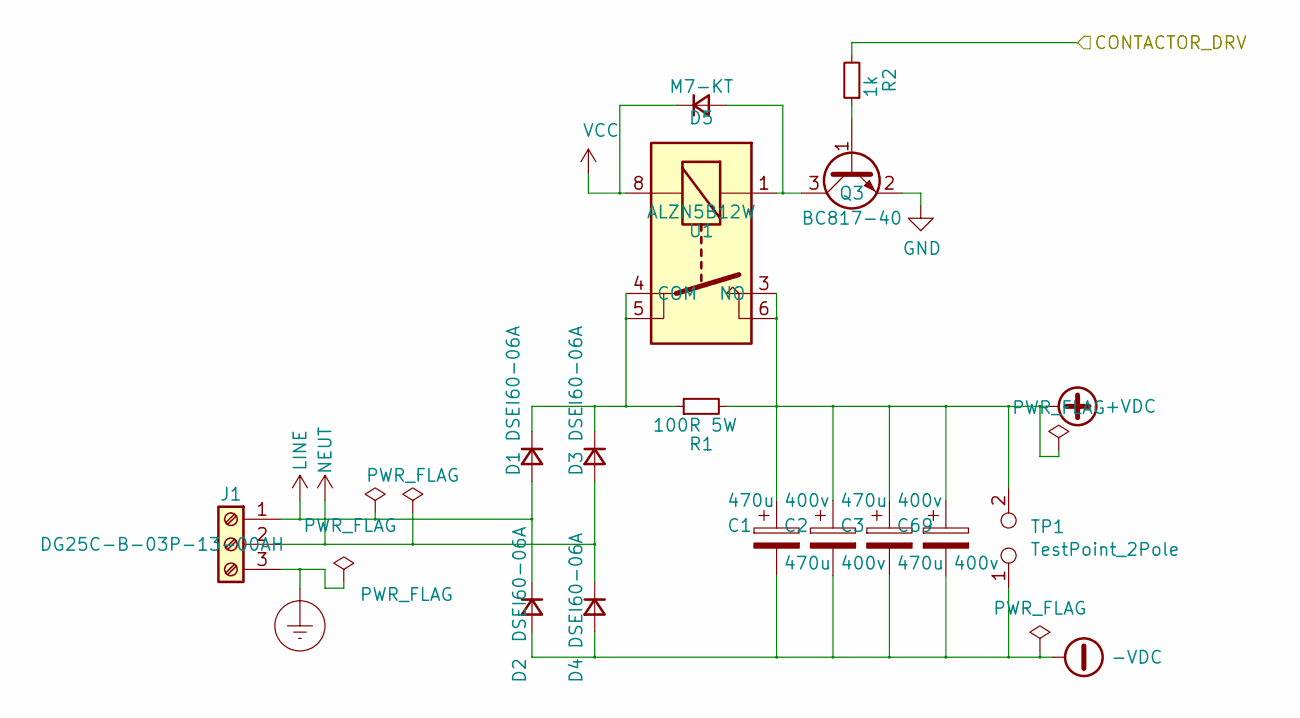
[picture p8: schematic PowerInput.kicad_sch]

Parts:
C1, C2, C3, C69: 470u 400v; CP_Radial_D35.0mm_P10.00mm_SnapIn
D1, D2, D3, D4: DSEI60-06A; TO-247-2_Vertical
D5: M7-KT; D_SMA
J1: DG25C-B-03P-13-00AH
Q3: BC817-40; SOT-23
R1: 100R 5W; R_Axial_Power_L25.0mm_W9.0mm_P30.48mm
R2: 1k; R_0805_2012Metric
TP1: TestPoint_2Pole; PinHeader_1x02_P2.54mm_Vertical
U1: ALZN5B12W

Connections:
+VDC: C1.1, C2.1, C3.1, C69.1, R1.2, TP1.2, U1.3 (NO), U1.6; also elsewhere on the board
-VDC: C1.2, C2.2, C3.2, C69.2, D2.2 (A), D4.2 (A), TP1.1; also elsewhere on the board
/CONTACTOR_DRV: R2.2; also elsewhere on the board
Earth_Protective: J1.3; also elsewhere on the board
GND: Q3.2 (E); also elsewhere on the board
LINE: D1.2 (A), D2.1 (K), J1.1; also elsewhere on the board
NEUT: D3.2 (A), D4.1 (K), J1.2; also elsewhere on the board
unnamed: D1.1 (K), D3.1 (K), R1.1, U1.4 (COM), U1.5
unnamed: D5.2 (A), Q3.3 (C), U1.1
unnamed: Q3.1 (B), R2.1
VCC: D5.1 (K), U1.8; also elsewhere on the board

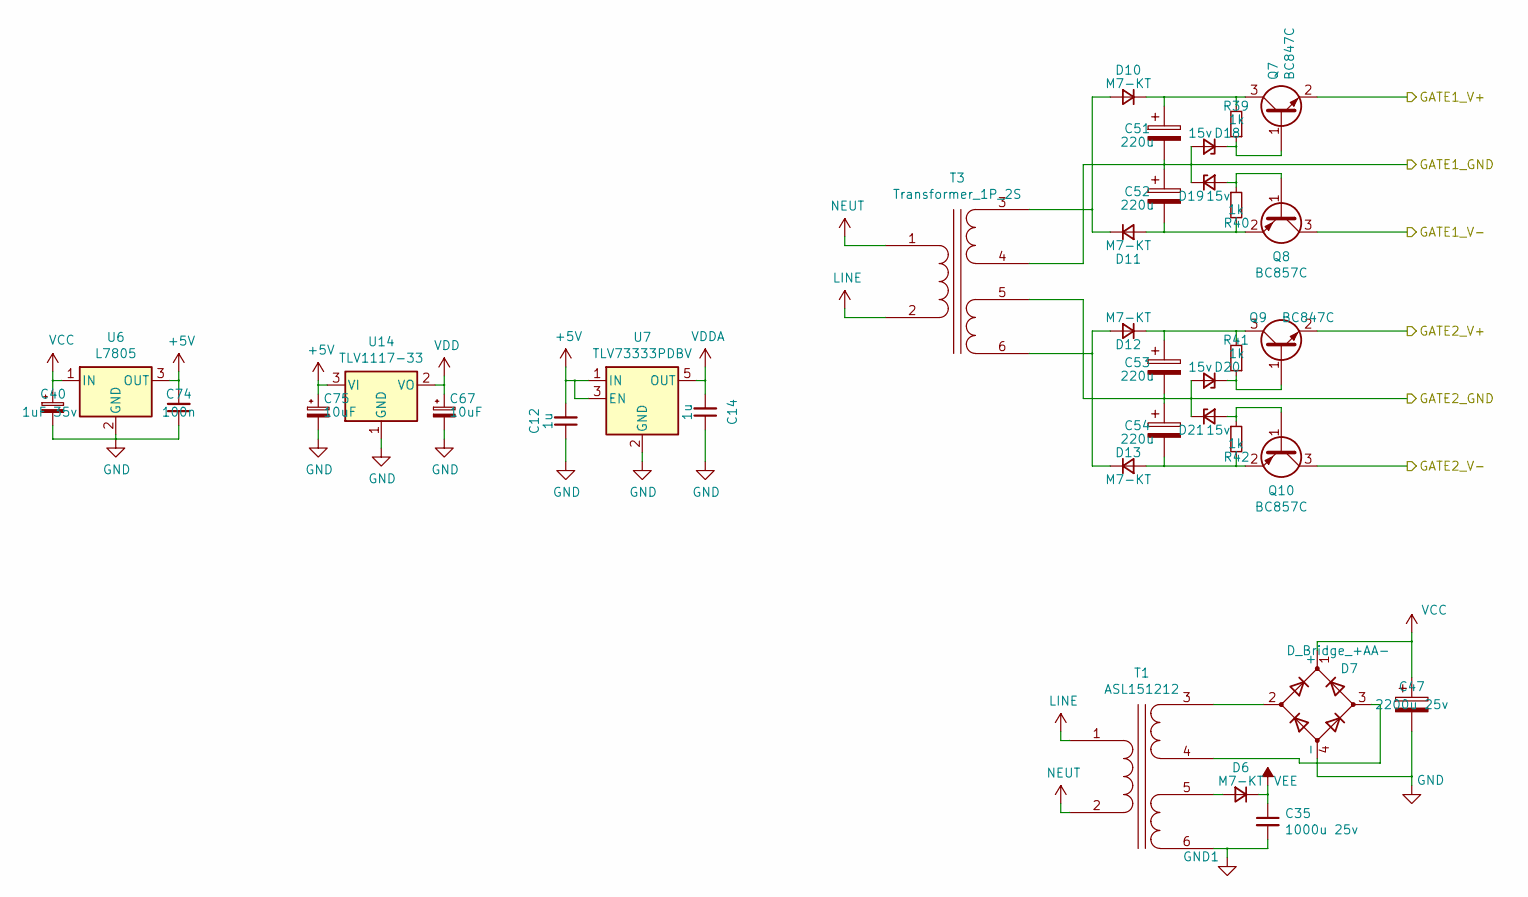
[picture p9: schematic PowerSources.kicad_sch]

Parts:
C12, C14: 1u; C_0805_2012Metric
C35: 1000u 25v; CP_Radial_D10.0mm_P5.00mm
C40: 1uF 35v; C_1206_3216Metric
C47: 2200u 25v; CP_Radial_D13.0mm_P5.00mm
C51, C52, C53, C54: 220u; CP_Radial_D6.3mm_P2.50mm
C67, C75: 10uF; CP_EIA-6032-15_Kemet-U
C74: 100n; C_0805_2012Metric
D6, D10, D11, D12, D13: M7-KT; D_SMA
D7: D_Bridge_+AA-; Diode_Bridge_Vishay_KBU
D18, D19, D20, D21: 15v; D_SOD-123
Q7, Q9: BC847C; SOT-23
Q8, Q10: BC857C; SOT-23
R39, R40, R41, R42: 1k; R_0805_2012Metric
T1: ASL151212
T3: Transformer_1P_2S; ASL102212
U6: L7805; TO-252-2
U7: TLV73333PDBV; SOT-23-5
U14: TLV1117-33; SOT-223-3_TabPin2

Connections:
+5V: C12.2, C74.2, C75.1, U6.3 (OUT), U7.1 (IN), U7.3 (EN), U14.3 (VI); also elsewhere on the board
-VDC: C53.2, C54.1, D20.2 (A), D21.1 (K), T3.5 (SC); also elsewhere on the board
/GATE1_GND: C51.2, C52.1, D18.2 (A), D19.1 (K), T3.4 (SB); also elsewhere on the board
/GATE1_V+: Q7.2 (E); also elsewhere on the board
/GATE1_V-: Q8.3 (C); also elsewhere on the board
/GATE2_V+: Q9.2 (E); also elsewhere on the board
/GATE2_V-: Q10.3 (C); also elsewhere on the board
GND: C12.1, C14.1, C40.2, C47.2, C67.2, C74.1, C75.2, D7.4 (-), U6.2 (GND), U7.2 (GND), U14.1 (GND); also elsewhere on the board
GND1: C35.2, T1.6 (SD); also elsewhere on the board
LINE: T1.1 (AA), T3.2 (AB); also elsewhere on the board
NEUT: T1.2 (AB), T3.1 (AA); also elsewhere on the board
unnamed: C51.1, D10.1 (K), Q7.3 (C), R39.2
unnamed: C52.2, D11.2 (A), Q8.2 (E), R40.2
unnamed: C53.1, D12.1 (K), Q9.3 (C), R41.2
unnamed: C54.2, D13.2 (A), Q10.2 (E), R42.2
unnamed: D6.2 (A), T1.5 (SC)
unnamed: D7.2 (~~), T1.3 (SA)
unnamed: D7.3 (~~), T1.4 (SB)
unnamed: D10.2 (A), D11.1 (K), T3.3 (SA)
unnamed: D12.2 (A), D13.1 (K), T3.6 (SD)
unnamed: D18.1 (K), Q7.1 (B), R39.1
unnamed: D19.2 (A), Q8.1 (B), R40.1
unnamed: D20.1 (K), Q9.1 (B), R41.1
unnamed: D21.2 (A), Q10.1 (B), R42.1
VCC: C40.1, C47.1, D7.1 (+), U6.1 (IN); also elsewhere on the board
VDD: C67.1, U14.2 (VO); also elsewhere on the board
VDDA: C14.2, U7.5 (OUT); also elsewhere on the board
VEE: C35.1, D6.1 (K); also elsewhere on the board

Board: 2 copper layers, 171 parts (0 on the bottom side), 99 nets, no tracks yet.
