onurefe/Lattice/v1.1/Hardware/WaveUltrasonics.kicad_pcb

## KiCad design v1.1/Hardware/WaveUltrasonics.kicad_pcb (2020-09-02, an earlier design)

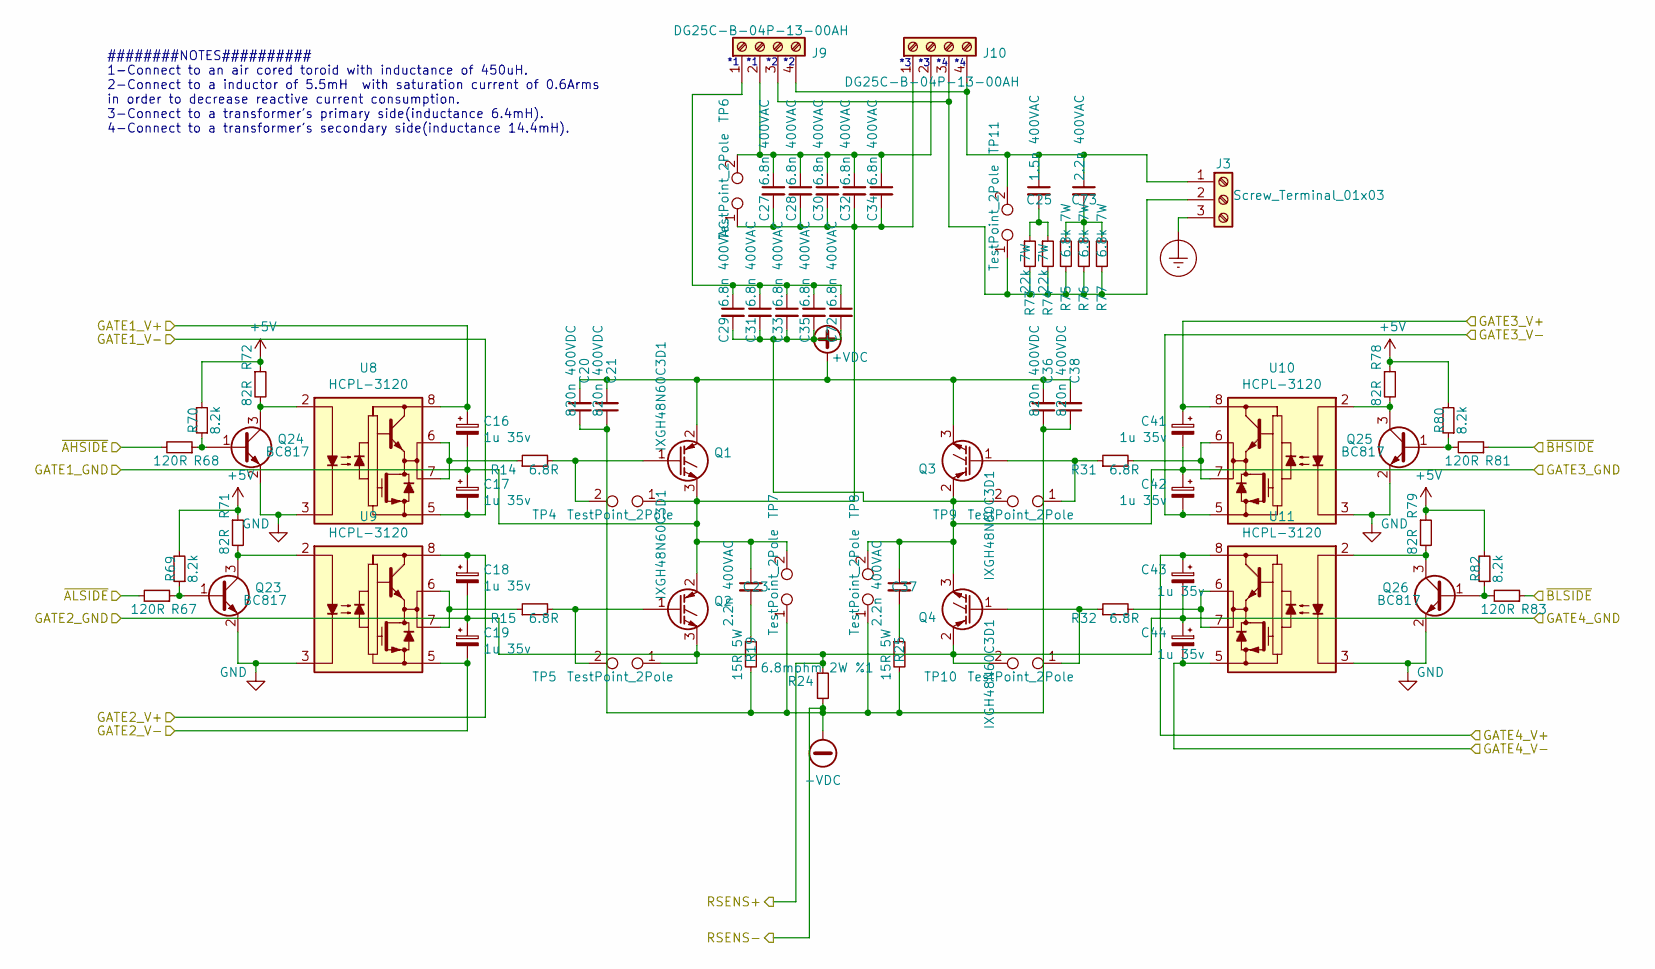
[picture p10: schematic HBridge.kicad_sch]

Parts:
C16, C17, C18, C19, C41, C42, C43, C44: 1u 35v; CP_Radial_D5.0mm_P2.50mm
C20, C21, C36, C38: 820n 400VDC; C_Rect_L24.0mm_W10.1mm_P22.50mm_MKT
C23, C37, C73: 2.2n 400VAC; C_Rect_L13.0mm_W4.0mm_P10.00mm_FKS3_FKP3_MKS4
C25: 1.5n 400VAC; C_Rect_L18.0mm_W5.0mm_P15.00mm_FKS3_FKP3
C27, C28, C29, C30, C31, C32, C33, C34, C35, C72: 6.8n 400VAC; C_Rect_L18.0mm_W5.0mm_P15.00mm_FKS3_FKP3
J3: Screw_Terminal_01x03; DG25C-B-03P-13-00AH
J9, J10: DG25C-B-04P-13-00AH
Q1, Q2, Q3, Q4: IXGH48N60C3D1; TO-247-3_Vertical
Q23, Q24, Q25, Q26: BC817; SOT-23
R14, R15, R31, R32: 6.8R; R_Axial_DIN0207_L6.3mm_D2.5mm_P10.16mm_Horizontal
R19, R25: 15R 5W; R_Axial_Power_L25.0mm_W9.0mm_P30.48mm
R24: 6.8mohm 2W %1; R_2512_6332Metric
R67, R68, R81, R83: 120R; R_0805_2012Metric
R69, R70, R80, R82: 8.2k; R_0805_2012Metric
R71, R72, R78, R79: 82R; R_0805_2012Metric
R73, R74: 22k 7W; R_Axial_DIN0922_L20.0mm_D9.0mm_P30.48mm_Horizontal
R75, R76, R77: 6.8k 7W; R_Axial_Power_L25.0mm_W9.0mm_P30.48mm
TP4, TP5, TP6, TP7, TP8, TP9, TP10, TP11: TestPoint_2Pole; PinHeader_1x02_P2.54mm_Vertical
U8, U9, U10, U11: HCPL-3120; DIP-8_W7.62mm

Connections:
+5V: R69.2, R70.2, R71.1, R72.1, R78.1, R79.1, R80.2, R82.2; also elsewhere on the board
-VDC: C20.1, C21.1, C36.1, C38.1, R19.2, R24.2, R25.2, TP7.1, TP8.1; also elsewhere on the board
/GATE1_GND: C16.2, C17.1, C23.1, C27.2, C28.2, C30.2, C32.2, C34.2, J10.1, Q1.3 (E), Q2.2 (C), TP4.1, TP6.1, TP7.2; also elsewhere on the board
/GATE1_V+: C16.1, U8.8 (VCC); also elsewhere on the board
/GATE1_V-: C17.2, U8.5 (VEE); also elsewhere on the board
/GATE2_V+: C18.1, U9.8 (VCC); also elsewhere on the board
/GATE2_V-: C19.2, U9.5 (VEE); also elsewhere on the board
/GATE3_V+: C41.1, U10.8 (VCC); also elsewhere on the board
/GATE3_V-: C42.2, U10.5 (VEE); also elsewhere on the board
/GATE4_V+: C43.1, U11.8 (VCC); also elsewhere on the board
/GATE4_V-: C44.2, U11.5 (VEE); also elsewhere on the board
/~HBRIDGE_A_HSIDE: R68.2; also elsewhere on the board
/~HBRIDGE_A_LSIDE: R67.2; also elsewhere on the board
/~HBRIDGE_B_HSIDE: R81.1; also elsewhere on the board
/~HBRIDGE_B_LSIDE: R83.1; also elsewhere on the board
Earth_Protective: J3.3; also elsewhere on the board
GND: Q23.2 (E), Q24.2 (E), Q25.2 (E), Q26.2 (E), U8.3 (C), U9.3 (C), U10.3 (C), U11.3 (C); also elsewhere on the board
unnamed: C23.2, R19.1
unnamed: C25.1, C73.1, J3.1, J9.4, J10.4, TP11.2
unnamed: C25.2, R73.1, R74.1
unnamed: C27.1, C28.1, C30.1, C32.1, C34.1, J9.2, J10.2, TP6.2
unnamed: C37.2, R25.1
unnamed: C73.2, R75.1, R76.1, R77.1
unnamed: J3.2, J9.3, J10.3, R73.2, R74.2, R75.2, R76.2, R77.2, TP11.1
unnamed: Q1.1 (G), R14.2, TP4.2
unnamed: Q2.1 (G), R15.2, TP5.2
unnamed: Q3.1 (G), R31.1, TP9.1
unnamed: Q4.1 (G), R32.1, TP10.1
unnamed: Q23.1 (B), R67.1, R69.1
unnamed: Q23.3 (C), R71.2, U9.2 (A)
unnamed: Q24.1 (B), R68.1, R70.1
unnamed: Q24.3 (C), R72.2, U8.2 (A)
unnamed: Q25.1 (B), R80.1, R81.2
unnamed: Q25.3 (C), R78.2, U10.2 (A)
unnamed: Q26.1 (B), R82.1, R83.2
unnamed: Q26.3 (C), R79.2, U11.2 (A)
unnamed: R14.1, U8.6 (VO), U8.7 (VO)
unnamed: R15.1, U9.6 (VO), U9.7 (VO)
unnamed: R31.2, U10.6 (VO), U10.7 (VO)
unnamed: R32.2, U11.6 (VO), U11.7 (VO)

Notes on the sheet:
########NOTES########## 1-Connect to an air cored toroid with inductance of 450uH. 2-Connect to a inductor of 5.5mH with saturation current of 0.6Arms in order to decrease reactive current consumption. 3-Connect to a transformer's primary side(inductance 6.4mH). 4-Connect to a transformer's seconda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

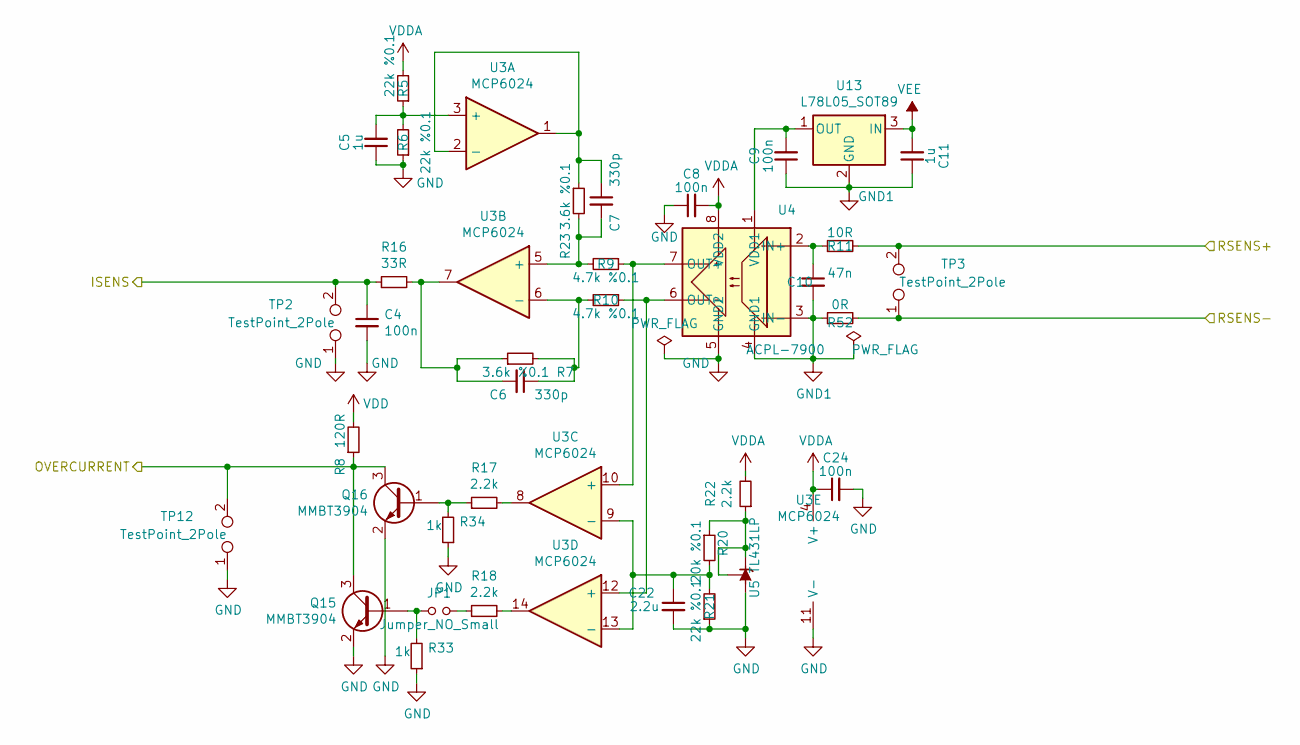
[picture p11: schematic IsensAfe.kicad_sch]

Parts:
C4: 100n; R_0805_2012Metric
C5, C11: 1u; C_0805_2012Metric
C6, C7: 330p; C_0805_2012Metric
C8, C9, C24: 100n; C_0805_2012Metric
C10: 47n; C_0805_2012Metric
C22: 2.2u; C_0805_2012Metric
JP1: Jumper_NO_Small; PinHeader_1x02_P2.54mm_Vertical
Q15, Q16: MMBT3904; SOT-23
R5, R6, R21: 22k %0.1; R_0805_2012Metric
R7, R23: 3.6k %0.1; R_0805_2012Metric
R8: 120R; R_0805_2012Metric
R9, R10: 4.7k %0.1; R_0805_2012Metric
R11: 10R; R_0805_2012Metric
R16: 33R; R_0805_2012Metric
R17, R18, R22: 2.2k; R_0805_2012Metric
R20: 20k %0.1; R_0805_2012Metric
R33, R34: 1k; R_0805_2012Metric
R52: 0R; R_0805_2012Metric
TP2, TP3, TP12: TestPoint_2Pole; PinHeader_1x02_P2.54mm_Vertical
U3: MCP6024; SOIC-14_3.9x8.7mm_P1.27mm
U4: ACPL-7900; SSO-8_6.7x9.8mm_P2.54mm_Clearance8mm
U5: TL431LP; SOT-23
U13: L78L05_SOT89; SOT-89-3

Connections:
-VDC: R52.2, TP3.1; also elsewhere on the board
/ISENS: C4.1, R16.1, TP2.2; also elsewhere on the board
/OVERCURRENT: Q15.3 (C), Q16.3 (C), R8.1, TP12.2; also elsewhere on the board
GND: C4.2, C5.1, C8.1, C22.2, C24.2, Q15.2 (E), Q16.2 (E), R6.1, R21.1, R33.1, R34.1, TP2.1, TP12.1, U3.11 (V-), U4.5 (GND2), U5.3 (A); also elsewhere on the board
GND1: C9.1, C10.2, C11.1, R52.1, U4.3 (IN-), U4.4 (GND1), U13.2 (GND); also elsewhere on the board
unnamed: C5.2, R5.1, R6.2, U3.3 (+)
unnamed: C6.1, R7.2, R10.2, U3.6 (-)
unnamed: C6.2, R7.1, R16.2, U3.7
unnamed: C7.1, R23.1, U3.1, U3.2 (-)
unnamed: C7.2, R9.2, R23.2, U3.5 (+)
unnamed: C9.2, U4.1 (VDD1), U13.1 (OUT)
unnamed: C10.1, R11.1, U4.2 (IN+)
unnamed: C22.1, R20.2, R21.2, U3.9 (-), U3.13 (-)
unnamed: JP1.1, Q15.1 (B), R33.2
unnamed: JP1.2, R18.1
unnamed: Q16.1 (B), R17.1, R34.2
unnamed: R9.1, U3.10 (+), U4.7 (OUT+)
unnamed: R10.1, U3.12 (+), U4.6 (OUT-)
unnamed: R17.2, U3.8
unnamed: R18.2, U3.14
unnamed: R20.1, R22.1, U5.1 (K), U5.2 (REF)
VDD: R8.2; also elsewhere on the board
VDDA: C8.2, C24.1, R5.2, R22.2, U3.4 (V+), U4.8 (VDD2); also elsewhere on the board
VEE: C11.2, U13.3 (IN); also elsewhere on the board

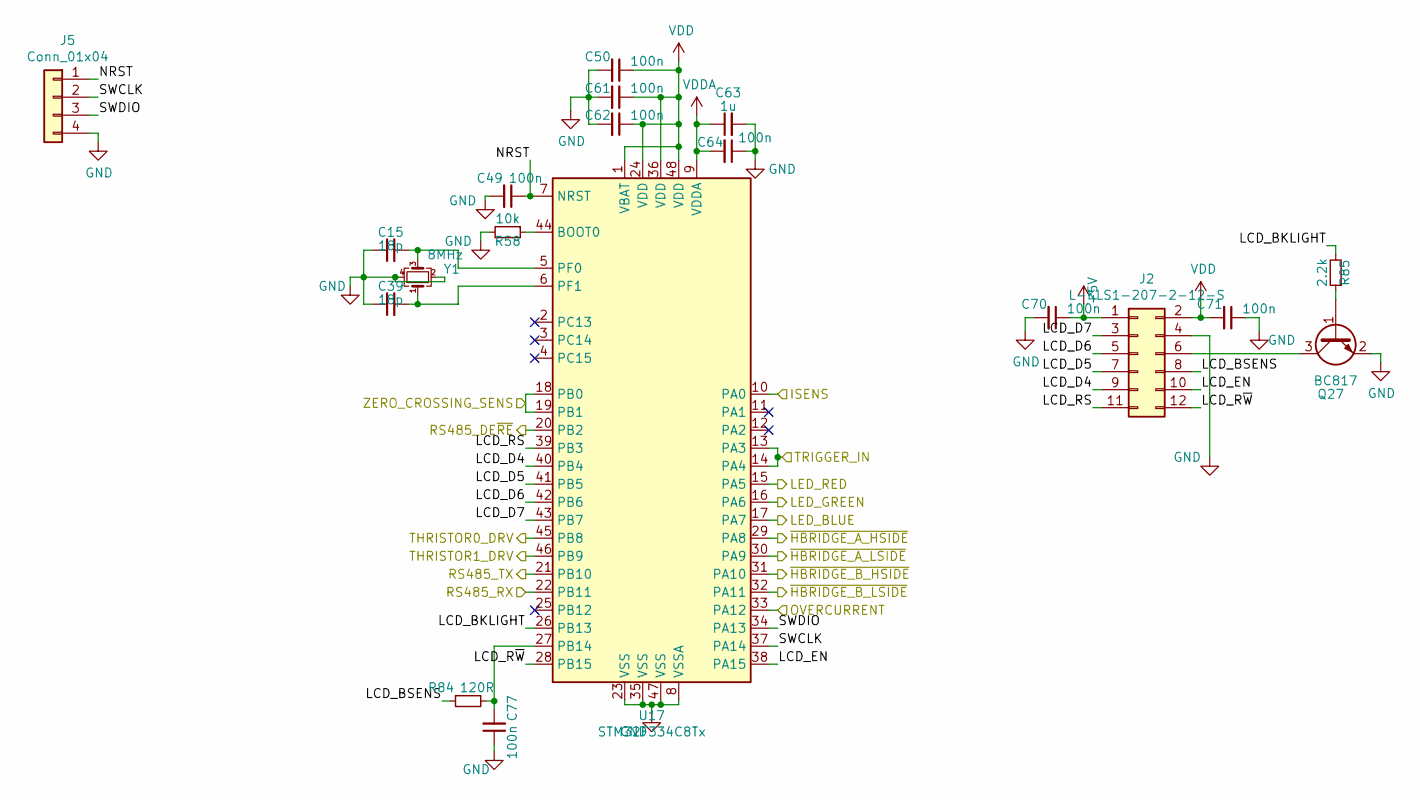
[picture p12: schematic Mcu.kicad_sch]

Parts:
C15, C39: 18p; C_0603_1608Metric
C49, C50, C61, C62, C64, C70, C71, C77: 100n; C_0805_2012Metric
C63: 1u; C_0805_2012Metric
J2: L-KLS1-207-2-12-S; PinHeader_2x06_P2.54mm_Vertical
J5: Conn_01x04; PinHeader_1x04_P2.54mm_Vertical
Q27: BC817; SOT-23
R58: 10k; R_0805_2012Metric
R84: 120R; R_0805_2012Metric
R85: 2.2k; R_0805_2012Metric
U17: STM32F334C8Tx; LQFP-48_7x7mm_P0.5mm
Y1: 8MHz; Crystal_5x3.2mm_4leads

Connections:
+5V: C70.1, J2.1; also elsewhere on the board
/ISENS: U17.10 (PA0); also elsewhere on the board
/LED_BLUE: U17.17 (PA7); also elsewhere on the board
/LED_GREEN: U17.16 (PA6); also elsewhere on the board
/LED_RED: U17.15 (PA5); also elsewhere on the board
/Mcu/LCD_BKLIGHT: R85.2, U17.26 (PB13)
/Mcu/LCD_BSENS: J2.8, R84.1
/Mcu/LCD_D4: J2.9, U17.40 (PB4)
/Mcu/LCD_D5: J2.7, U17.41 (PB5)
/Mcu/LCD_D6: J2.5, U17.42 (PB6)
/Mcu/LCD_D7: J2.3, U17.43 (PB7)
/Mcu/LCD_EN: J2.10, U17.38 (PA15)
/Mcu/LCD_RS: J2.11, U17.39 (PB3)
/Mcu/LCD_R~W: J2.12, U17.28 (PB15)
/Mcu/NRST: C49.1, J5.1, U17.7 (NRST)
/Mcu/SWCLK: J5.2, U17.37 (PA14)
/Mcu/SWDIO: J5.3, U17.34 (PA13)
/OVERCURRENT: U17.33 (PA12); also elsewhere on the board
/RS485_DE~RE: U17.20 (PB2); also elsewhere on the board
/RS485_RX: U17.22 (PB11); also elsewhere on the board
/RS485_TX: U17.21 (PB10); also elsewhere on the board
/THRISTOR0_DRV: U17.45 (PB8); also elsewhere on the board
/THRISTOR1_DRV: U17.46 (PB9); also elsewhere on the board
/TRIGOUT: U17.13 (PA3), U17.14 (PA4); also elsewhere on the board
/ZERO_CROSSING: U17.18 (PB0), U17.19 (PB1); also elsewhere on the board
/~HBRIDGE_A_HSIDE: U17.29 (PA8); also elsewhere on the board
/~HBRIDGE_A_LSIDE: U17.30 (PA9); also elsewhere on the board
/~HBRIDGE_B_HSIDE: U17.31 (PA10); also elsewhere on the board
/~HBRIDGE_B_LSIDE: U17.32 (PA11); also elsewhere on the board
GND: C15.1, C39.1, C49.2, C50.2, C61.2, C62.2, C63.2, C64.1, C70.2, C71.1, C77.1, J2.4, J5.4, Q27.2 (E), R58.2, U17.8 (VSSA), U17.23 (VSS), U17.35 (VSS), U17.47 (VSS), Y1.2, Y1.4; also elsewhere on the board
unnamed: C15.2, U17.5 (PF0), Y1.3
unnamed: C39.2, U17.6 (PF1), Y1.1
unnamed: C77.2, R84.2, U17.27 (PB14)
unnamed: J2.6, Q27.3 (C)
unnamed: Q27.1 (B), R85.1
unnamed: R58.1, U17.44 (BOOT0)
VDD: C50.1, C61.1, C62.1, C71.2, J2.2, U17.1 (VBAT), U17.24 (VDD), U17.36 (VDD), U17.48 (VDD); also elsewhere on the board
VDDA: C63.1, C64.2, U17.9 (VDDA); also elsewhere on the board
