onurefe/Lattice/v1.1/Hardware/WaveUltrasonics.kicad_pcb

## KiCad design v1.1/Hardware/WaveUltrasonics.kicad_pcb (continued)

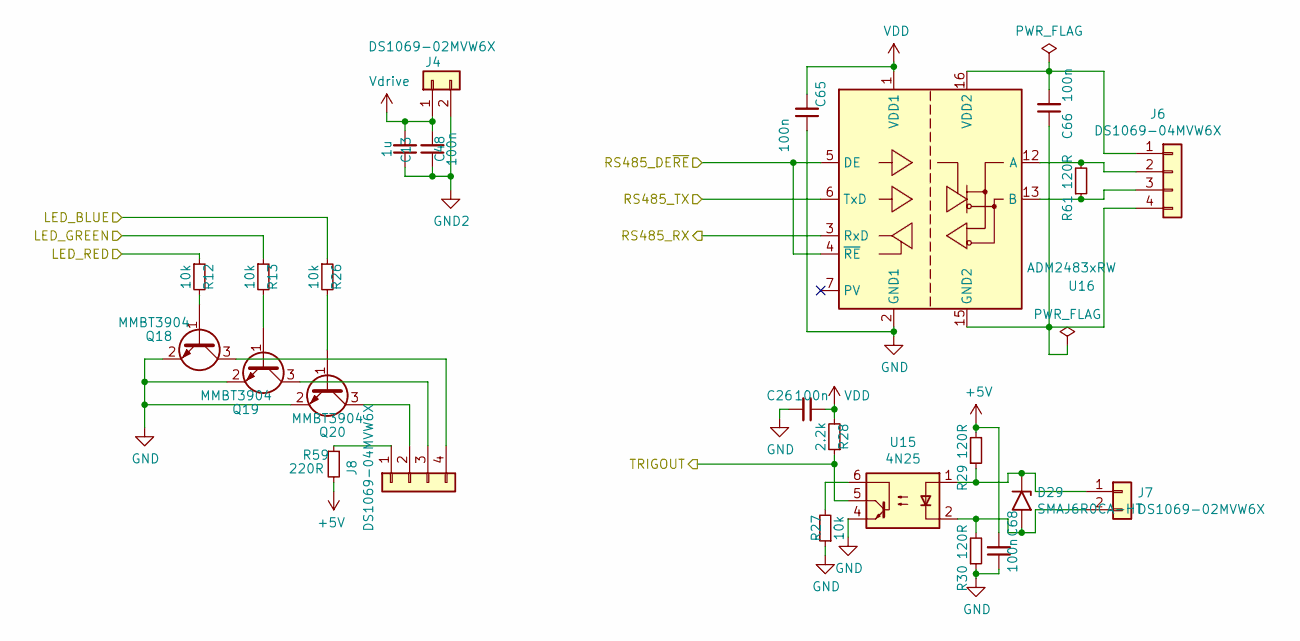
[picture p13: schematic Misc.kicad_sch]

Parts:
C13: 1u; C_0805_2012Metric
C26, C48, C65, C66, C68: 100n; C_0805_2012Metric
D29: SMAJ6R0CA-HT; DO214AC_SMA
J4, J7: DS1069-02MVW6X; JST_EH_B2B-EH-A_1x02_P2.50mm_Vertical
J6, J8: DS1069-04MVW6X; JST_EH_B4B-EH-A_1x04_P2.50mm_Vertical
Q18, Q19, Q20: MMBT3904; SOT-23
R12, R13, R26, R27: 10k; R_0805_2012Metric
R28: 2.2k; R_0805_2012Metric
R29, R30, R61: 120R; R_0805_2012Metric
R59: 220R; R_0805_2012Metric
U15: 4N25; DIP-6_W7.62mm
U16: ADM2483xRW; SOIC-16W_7.5x10.3mm_P1.27mm

Connections:
+5V: C68.2, R29.2, R59.2; also elsewhere on the board
/LED_BLUE: R26.1; also elsewhere on the board
/LED_GREEN: R13.1; also elsewhere on the board
/LED_RED: R12.1; also elsewhere on the board
/RS485_DE~RE: U16.4 (~RE), U16.5 (DE); also elsewhere on the board
/RS485_RX: U16.3 (RxD); also elsewhere on the board
/RS485_TX: U16.6 (TxD); also elsewhere on the board
/TRIGOUT: R28.1, U15.5; also elsewhere on the board
GND: C26.2, C65.1, C68.1, Q18.2 (E), Q19.2 (E), Q20.2 (E), R27.1, R30.1, U15.4, U16.2 (GND1), U16.8 (GND1); also elsewhere on the board
GND2: C13.1, C48.1, J4.2; also elsewhere on the board
unnamed: C66.1, J6.4, U16.9 (GND2), U16.15 (GND2)
unnamed: C66.2, J6.1, U16.16 (VDD2)
unnamed: D29.1 (A1), J7.1, R29.1, U15.1
unnamed: D29.2 (A2), J7.2, R30.2, U15.2
unnamed: J6.2, R61.2, U16.12 (A)
unnamed: J6.3, R61.1, U16.13 (B)
unnamed: J8.1, R59.1
unnamed: J8.2, Q20.3 (C)
unnamed: J8.3, Q19.3 (C)
unnamed: J8.4, Q18.3 (C)
unnamed: Q18.1 (B), R12.2
unnamed: Q19.1 (B), R13.2
unnamed: Q20.1 (B), R26.2
unnamed: R27.2, U15.6
VDD: C26.1, C65.2, R28.2, U16.1 (VDD1); also elsewhere on the board
Vdrive: C13.2, C48.2, J4.1; also elsewhere on the board

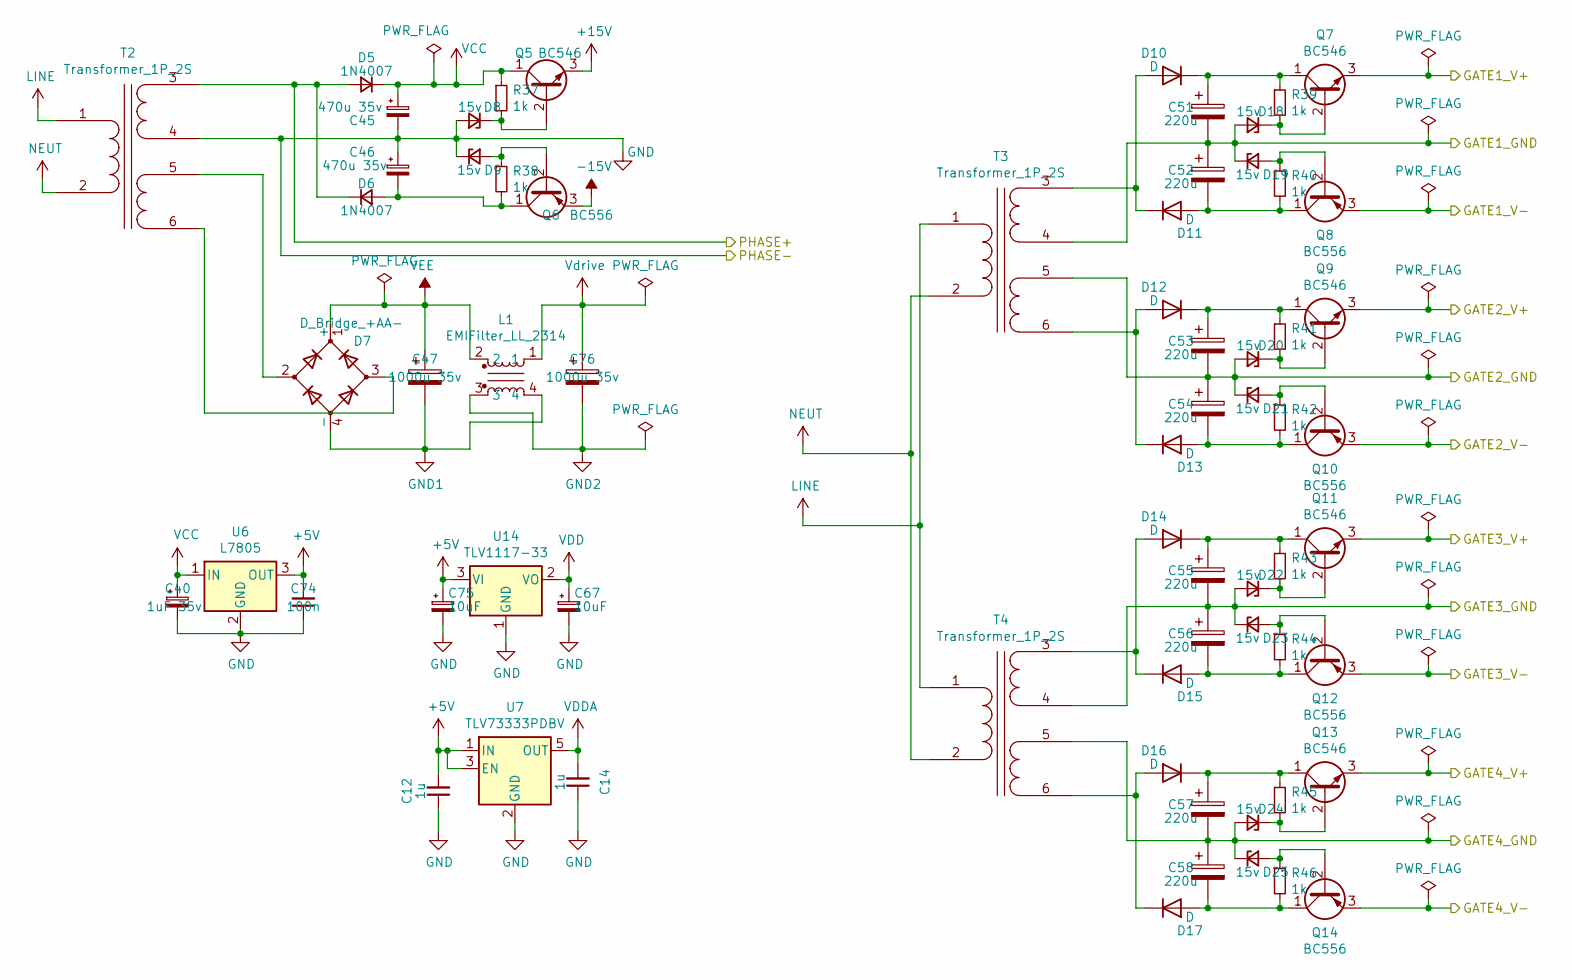
[picture p14: schematic PowerSources.kicad_sch]

Parts:
C12, C14: 1u; C_0805_2012Metric
C40: 1uF 35v; C_1206_3216Metric
C45, C46: 470u 35v; CP_Radial_D10.0mm_P5.00mm
C47, C76: 1000u 35v; CP_Radial_D12.5mm_P5.00mm
C51, C52, C53, C54, C55, C56, C57, C58: 220u; CP_Radial_D6.3mm_P2.50mm
C67, C75: 10uF; CP_EIA-6032-15_Kemet-U
C74: 100n; C_0805_2012Metric
D5, D6: 1N4007; D_A-405_P10.16mm_Horizontal
D7: D_Bridge_+AA-; Diode_Bridge_Vishay_KBU
D8, D9, D18, D19, D20, D21, D22, D23, D24, D25: 15v; D_DO-35_SOD27_P7.62mm_Horizontal
D10, D11, D12, D13, D14, D15, D16, D17: D; D_DO-35_SOD27_P7.62mm_Horizontal
L1: EMIFilter_LL_2314; EPCOS_B82721A
Q5, Q7, Q9, Q11, Q13: BC546; TO-92_Inline_Wide
Q6, Q8, Q10, Q12, Q14: BC556; TO-92_Inline_Wide
R37, R38, R39, R40, R41, R42, R43, R44, R45, R46: 1k; R_Axial_DIN0204_L3.6mm_D1.6mm_P5.08mm_Horizontal
T2: Transformer_1P_2S; ASL151212
T3, T4: Transformer_1P_2S; ASL102212
U6: L7805; TO-252-2
U7: TLV73333PDBV; SOT-23-5
U14: TLV1117-33; SOT-223-3_TabPin2

Connections:
+5V: C12.2, C74.2, C75.1, U6.3 (OUT), U7.1 (IN), U7.3 (EN), U14.3 (VI); also elsewhere on the board
+15V: Q5.3 (E); also elsewhere on the board
-15V: Q6.3 (E); also elsewhere on the board
/GATE1_GND: C51.2, C52.1, D18.2 (A), D19.1 (K), T3.4 (SB); also elsewhere on the board
/GATE1_V+: Q7.3 (E); also elsewhere on the board
/GATE1_V-: Q8.3 (E); also elsewhere on the board
/GATE2_V+: Q9.3 (E); also elsewhere on the board
/GATE2_V-: Q10.3 (E); also elsewhere on the board
/GATE3_V+: Q11.3 (E); also elsewhere on the board
/GATE3_V-: Q12.3 (E); also elsewhere on the board
/GATE4_V+: Q13.3 (E); also elsewhere on the board
/GATE4_V-: Q14.3 (E); also elsewhere on the board
/PHASE+: D5.2 (A), D6.1 (K), T2.3 (SA); also elsewhere on the board
GND: C12.1, C14.1, C40.2, C45.2, C46.1, C67.2, C74.1, C75.2, D8.2 (A), D9.1 (K), T2.4 (SB), U6.2 (GND), U7.2 (GND), U14.1 (GND); also elsewhere on the board
GND1: C47.2, D7.4 (-), L1.4; also elsewhere on the board
GND2: C76.2, L1.3; also elsewhere on the board
LINE: T2.1 (AA), T3.1 (AA), T4.1 (AA); also elsewhere on the board
NEUT: T2.2 (AB), T3.2 (AB), T4.2 (AB); also elsewhere on the board
unnamed: C46.2, D6.2 (A), Q6.1 (C), R38.2
unnamed: C51.1, D10.1 (K), Q7.1 (C), R39.1
unnamed: C52.2, D11.2 (A), Q8.1 (C), R40.2
unnamed: C53.1, D12.1 (K), Q9.1 (C), R41.1
unnamed: C54.2, D13.2 (A), Q10.1 (C), R42.2
unnamed: C55.1, D14.1 (K), Q11.1 (C), R43.1
unnamed: C56.2, D15.2 (A), Q12.1 (C), R44.2
unnamed: C57.1, D16.1 (K), Q13.1 (C), R45.1
unnamed: C58.2, D17.2 (A), Q14.1 (C), R46.2
unnamed: D7.2 (~~), T2.5 (SC)
unnamed: D7.3 (~~), T2.6 (SD)
unnamed: D8.1 (K), Q5.2 (B), R37.2
unnamed: D9.2 (A), Q6.2 (B), R38.1
unnamed: D10.2 (A), D11.1 (K), T3.3 (SA)
unnamed: D12.2 (A), D13.1 (K), T3.6 (SD)
unnamed: D14.2 (A), D15.1 (K), T4.3 (SA)
unnamed: D16.2 (A), D17.1 (K), T4.6 (SD)
unnamed: D18.1 (K), Q7.2 (B), R39.2
unnamed: D19.2 (A), Q8.2 (B), R40.1
unnamed: D20.1 (K), Q9.2 (B), R41.2
unnamed: D21.2 (A), Q10.2 (B), R42.1
unnamed: D22.1 (K), Q11.2 (B), R43.2
unnamed: D23.2 (A), Q12.2 (B), R44.1
unnamed: D24.1 (K), Q13.2 (B), R45.2
unnamed: D25.2 (A), Q14.2 (B), R46.1
VCC: C40.1, C45.1, D5.1 (K), Q5.1 (C), R37.1, U6.1 (IN)
VDD: C67.1, U14.2 (VO); also elsewhere on the board
VDDA: C14.2, U7.5 (OUT); also elsewhere on the board
VEE: C47.1, D7.1 (+), L1.2; also elsewhere on the board
Vdrive: C76.1, L1.1; also elsewhere on the board

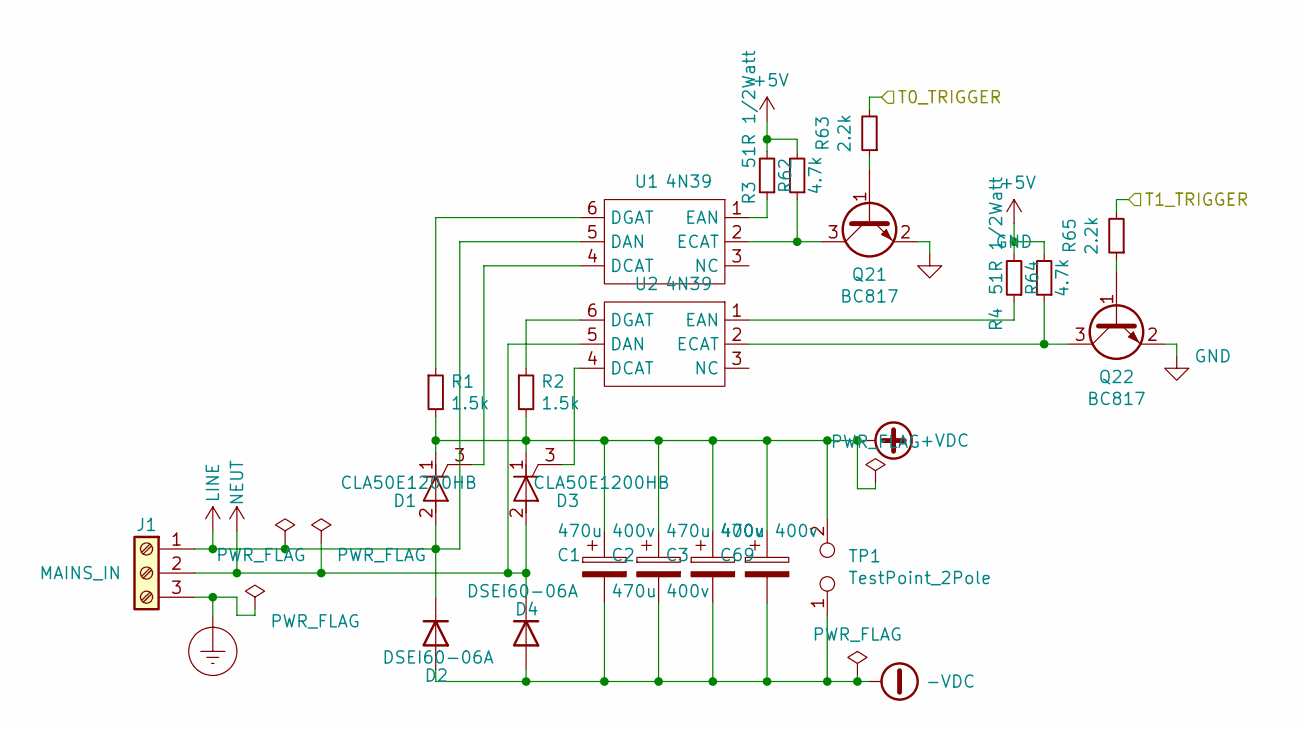
[picture p15: schematic SynchronousRectifier.kicad_sch]

Parts:
C1, C2, C3, C69: 470u 400v; CP_Radial_D35.0mm_P10.00mm_SnapIn
D1, D3: CLA50E1200HB; TO-247-3_Vertical
D2, D4: DSEI60-06A; TO-247-2_Vertical
J1: MAINS_IN; DG25C-B-03P-13-00AH
Q21, Q22: BC817; SOT-23
R1, R2: 1.5k; R_Axial_DIN0204_L3.6mm_D1.6mm_P7.62mm_Horizontal
R3, R4: 51R 1/2Watt; R_1210_3225Metric
R62, R64: 4.7k; R_0805_2012Metric
R63, R65: 2.2k; R_0805_2012Metric
TP1: TestPoint_2Pole; PinHeader_1x02_P2.54mm_Vertical
U1, U2: 4N39; DIP-6_W7.62mm

Connections:
+5V: R3.2, R4.2, R62.2, R64.2; also elsewhere on the board
-VDC: C1.2, C2.2, C3.2, C69.2, D2.2 (A), D4.2 (A), TP1.1; also elsewhere on the board
/THRISTOR0_DRV: R63.2; also elsewhere on the board
/THRISTOR1_DRV: R65.2; also elsewhere on the board
Earth_Protective: J1.3; also elsewhere on the board
GND: Q21.2 (E), Q22.2 (E); also elsewhere on the board
LINE: D1.2 (A), D2.1 (K), J1.1, U1.5 (DAN); also elsewhere on the board
NEUT: D3.2 (A), D4.1 (K), J1.2, U2.5 (DAN); also elsewhere on the board
unnamed: D1.3 (G), U1.4 (DCAT)
unnamed: D3.3 (G), U2.4 (DCAT)
unnamed: Q21.1 (B), R63.1
unnamed: Q21.3 (C), R62.1, U1.2 (ECAT)
unnamed: Q22.1 (B), R65.1
unnamed: Q22.3 (C), R64.1, U2.2 (ECAT)
unnamed: R1.1, U1.6 (DGAT)
unnamed: R2.1, U2.6 (DGAT)
unnamed: R3.1, U1.1 (EAN)
unnamed: R4.1, U2.1 (EAN)

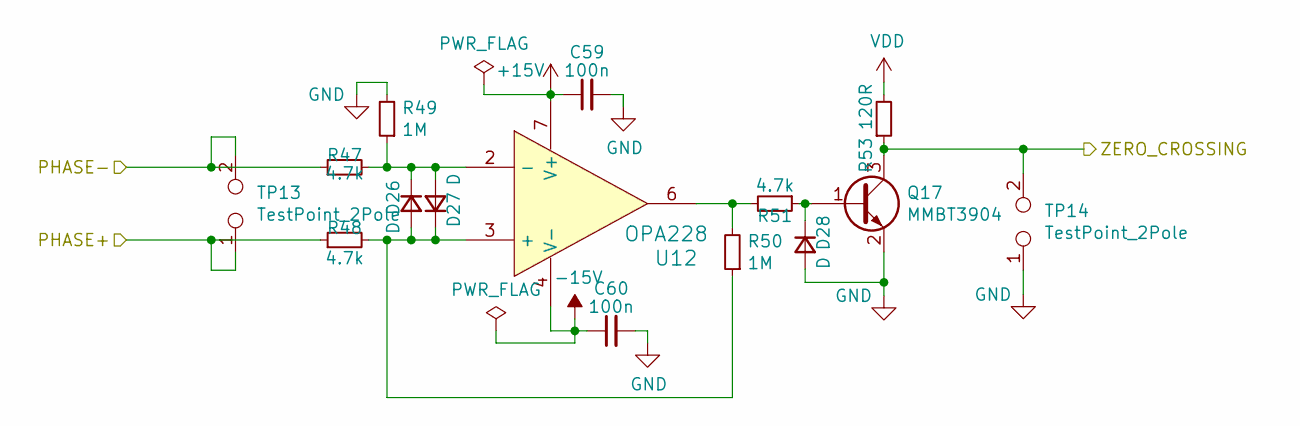
[picture p16: schematic ZeroCrossingDetector.kicad_sch]

Parts:
C59, C60: 100n; C_0805_2012Metric
D26, D27, D28: D; D_MiniMELF
Q17: MMBT3904; SOT-23
R47, R48, R51: 4.7k; R_0805_2012Metric
R49, R50: 1M; R_0805_2012Metric
R53: 120R; R_0805_2012Metric
TP13, TP14: TestPoint_2Pole; PinHeader_1x02_P2.54mm_Vertical
U12: OPA228; SOIC-8_3.9x4.9mm_P1.27mm

Connections:
+15V: C59.1, U12.7 (V+); also elsewhere on the board
-15V: C60.1, U12.4 (V-); also elsewhere on the board
/PHASE+: R48.1, TP13.1; also elsewhere on the board
/ZERO_CROSSING: Q17.3 (C), R53.1, TP14.2; also elsewhere on the board
GND: C59.2, C60.2, D28.2 (A), Q17.2 (E), R47.1, R49.2, TP13.2, TP14.1; also elsewhere on the board
unnamed: D26.1 (K), D27.2 (A), R47.2, R49.1, U12.2 (-)
unnamed: D26.2 (A), D27.1 (K), R48.2, R50.1, U12.3 (+)
unnamed: D28.1 (K), Q17.1 (B), R51.1
unnamed: R50.2, R51.2, U12.6
VDD: R53.2; also elsewhere on the board

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
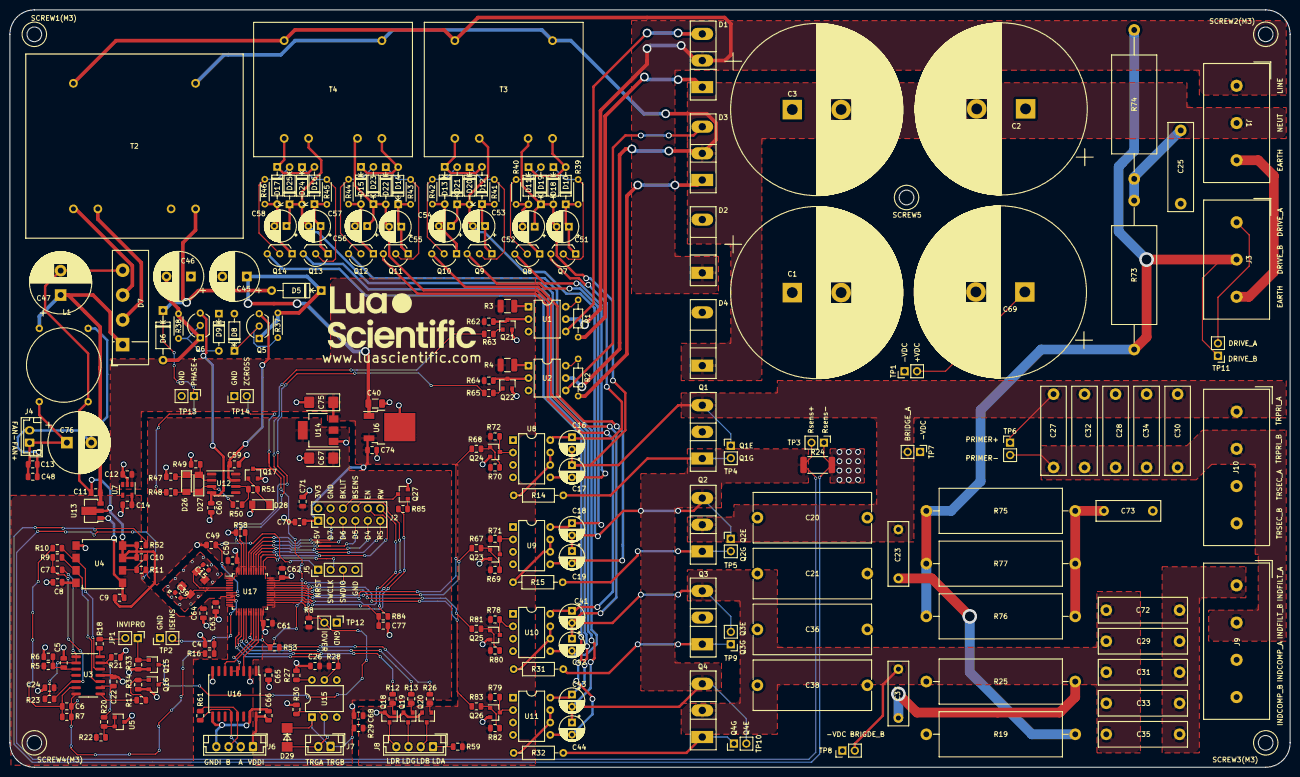
[picture p17: board v1.1/Hardware/WaveUltrasonics.kicad_pcb from above]

Board: 2 copper layers, 262.0 x 155.0 mm, 257 parts (0 on the bottom side), 155 nets.
