onurefe/Lattice/v1.3/Firmware/Src/main.c

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

  /* Includes ------------------------------------------------------------------*/
#include "main.h"
#include "lattice.h"
#include "eeprom_emulator.h"
ADC_HandleTypeDef hadc1;
DMA_HandleTypeDef hdma_adc1;

HRTIM_HandleTypeDef hhrtim1;

UART_HandleTypeDef huart1;
UART_HandleTypeDef huart3;

void SystemClock_Config(void);
static void MX_GPIO_Init(void);
static void MX_DMA_Init(void);
static void MX_HRTIM1_Init(void);
static void MX_ADC1_Init(void);
static void MX_USART1_UART_Init(void);
static void MX_USART3_UART_Init(void);
/**
  * @brief  The application entry point.
  * @retval int
  */
int main(void)
{
    /* MCU Configuration--------------------------------------------------------*/

    /* Reset of all peripherals, Initializes the Flash interface and the Systick. */
    HAL_Init();

    /* Configure the system clock */
    SystemClock_Config();

    /* Initialize all configured peripherals */
    MX_GPIO_Init();
    MX_DMA_Init();
    MX_HRTIM1_Init();
    MX_ADC1_Init();
    MX_USART1_UART_Init();
    MX_USART3_UART_Init();

    /* USER CODE BEGIN 2 */
    HAL_Delay(STARTUP_DELAY_IN_MS);

    // Turn on the contactor.
    EepromEmulator_Init();
    HAL_GPIO_WritePin(CONTACTOR_CTRL_GPIO_Port, CONTACTOR_CTRL_Pin, GPIO_PIN_RESET);
    Lattice_Start();
    /* USER CODE END 2 */

    /* Infinite loop */
    /* USER CODE BEGIN WHILE */
    while (1)
    {
        Lattice_Execute();
        /* USER CODE END WHILE */

        /* USER CODE BEGIN 3 */
    }
    /* USER CODE END 3 */
}

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
/* USER CODE BEGIN 4 */
void Lattice_StatusChangeCb(Lattice_Status_t *status)
{
}

void HAL_GPIO_EXTI_Callback(uint16_t GPIO_Pin)
{
    if (GPIO_Pin == TRIGIN_RISING_Pin)
    {
        Lattice_CmdPowerOutput(TRUE);
    }

    if (GPIO_Pin == TRIGIN_FALLING_Pin)
    {
        Lattice_CmdPowerOutput(FALSE);
    }
}

/* USER CODE END 4 */
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
