onurefe/Lattice/Lattice.ioc

Mcu.UserName=STM32F334C8Tx
PA0.GPIO_Label=ISENS+
PA0.Signal=ADC1_IN1
PA1.GPIO_Label=ISENS-
PA1.Signal=ADC1_IN2
PA10.Signal=HRTIM1_CHB1
PA11.Signal=HRTIM1_CHB2
PA12.GPIO_Label=OVERCURRENT
PA12.Signal=HRTIM1_FLT1
PA13.Signal=SYS_JTMS-SWDIO
PA14.Signal=SYS_JTCK-SWCLK
PA15.GPIO_Label=LCD_RS
PA15.Signal=GPIO_Output
PA2.GPIO_Label=VSENS+
PA2.Signal=ADC1_IN3
PA3.GPIO_Label=VSENS-
PA3.Signal=ADC1_IN4
PA4.GPIO_Label=TRGIN_RISING
PA4.Signal=GPXTI4
PA5.GPIO_Label=TRGIN_FALLING
PA5.Signal=GPXTI5
PA6.GPIO_Label=LED_RED
PA6.Signal=GPIO_Output
PA7.GPIO_Label=LED_GREEN
PA7.Signal=GPIO_Output
PA8.Signal=HRTIM1_CHA1
PA9.Signal=HRTIM1_CHA2
PB0.GPIO_Label=ZC_RISING_DETECT
PB0.Signal=S_TIM3_CH3
PB1.GPIO_Label=ZC_FALLING_DETECT
PB1.Signal=S_TIM3_CH4
PB10.GPIO_Label=RS485_TX
PB10.Signal=USART3_TX
PB11.GPIO_Label=RS485_RX
PB11.Signal=USART3_RX
PB12.GPIO_Label=LED_BLUE
PB12.Signal=GPIO_Output
PB14.GPIO_Label=LCD_BSENS
PB14.Signal=ADC2_IN14
PB15.GPIO_Label=LCD_RnW
PB15.Signal=GPIO_Output
PB2.GPIO_Label=RS485_DEnRE
PB2.Signal=GPIO_Output
PB3.GPIO_Label=LCD_EN
PB3.Signal=GPIO_Output
PB4.GPIO_Label=LCD_D4
PB4.Signal=GPIO_Output
PB5.GPIO_Label=LCD_D5
PB5.Signal=GPIO_Output
PB6.GPIO_Label=LCD_D6
PB6.Signal=GPIO_Output
PB7.GPIO_Label=LCD_D7
PB7.Signal=GPIO_Output
PB8.GPIO_Label=THYRISTOR0_DRIVE
PB8.Signal=GPIO_Output
PB9.GPIO_Label=THYRISTOR1_DRIVE
PB9.Signal=GPIO_Output
PC13.GPIO_Label=LED_RED
PC13.Signal=GPIO_Output
