onurefe/Lattice/v1.3/Firmware/Inc/polyreg.h

#ifndef __POLYREG_H
#define __POLYREG_H

#include "global.h"

/* Exported functions ------------------------------------------------------*/
extern void Polyreg_Fit1(float *samples, float *coefficients);

#endif
