onurefe/Lattice/(commit log)

2020-06-07 Only tested on the beta version of v1.0(nearly compatible for the firm).
    [BOM.xlsx, GateDriveSupplies.kicad_sch, HBridge.kicad_sch, IsensAfe.kicad_sch, Mcu.kicad_sch, Misc.kicad_sch, PowerSources.kicad_sch, SynchronousRectifier.kicad_sch]
2020-06-24 v1.1&v1.2 PCB addition.
    #####v1.1#####
    +Change of MCU; STM32F334C8T6 instead of STM32F103C8T6.
    +Filtering 3rd order components of the square wave.
    +Use 4 capacitors.
    +Adapted to generic transformer(primary 6.4mH, secondary 14.4mH)
    +Faster IGBT.
    ########v1.2#######
    +Measures only PZT current and voltage.
    +Differential inputs.
    +Analog circuitry is capable of measuring four quadrant voltage, current and complex impedance.
    +Half bridge configuration.
    +Gate resistance of the IGBT's lowered.
    +Only USART based touch panel can be connected; not conventional LCD.
    [Afe.kicad_sch, BOM.xlsx, GateDriveSupplies.kicad_sch, HBridge.kicad_sch, IsensAfe.kicad_sch, Mcu.kicad_sch, Misc.kicad_sch, PowerSources.kicad_sch]
2020-07-08 Addition of firmware to v1.2(not tested)
    +Addition of power tracking(with duty cycle control).
    +Addition of resonance freq tracking(via proprietary algorithm relied on active and reactive power measurements)
    +Quality factor monitoring
    +Power boost when loaded(idle and loaded modes)
    +Much better frequency resolution(less than 1Hz)
    [Afe.kicad_sch, BOM v1.2.xlsx, BOM.xlsx, HBridge.kicad_sch, Mcu.kicad_sch, Misc.kicad_sch, PowerSources.kicad_sch, SynchronousRectifier.kicad_sch]
2020-09-02 Start of rs485 communication interface development.
    [Afe.kicad_sch, BOM v1.2.xlsx, BOM v1.3.xlsx, GateDriveSupplies.kicad_sch, HBridge.kicad_sch, Mcu.kicad_sch, Misc.kicad_sch, PowerInput.kicad_sch]
2020-09-09 Redesign.
    +Cli interface.
    +Modularity improvement(complex number and pid modules created)
    +Range change.
    +Core-Lattice seperated.
    +Improvement of the control function
    [Afe.kicad_sch, HBridge.kicad_sch, Mcu.kicad_sch, Misc.kicad_sch, PowerSources.kicad_sch, SynchronousRectifier.kicad_sch, WaveUltrasonics.kicad_sch, ZeroCrossingDetector.kicad_sch]
2020-09-10 Progress in redesign. Error detection addition.
    [core.c, core.h, lattice.c, lattice.h, main.c]
2020-09-10 Lattice state machine polishing, improvements of error monitoring.
    [core.c, core.h, lattice.c, lattice.h]
2020-09-11 Voltage and current processing bugfix and addition of related unit test.
    +Imaginary component had sign error.
    +getPhasors function wasn't returning value.
    [core.c, core.h, global.h, test.cpp]
2020-09-11 Test of PID and Polynomial regression modules.
2020-10-27 Serial interface development. Manual added. Untested.
    [Afe.kicad_sch, HBridge.kicad_sch, Mcu.kicad_sch, Misc.kicad_sch, PowerInput.kicad_sch, PowerSources.kicad_sch, WaveUltrasonics.kicad_sch]
2020-10-27 v1.3 Schematic, footprints and BOM updated.
    [Afe.kicad_sch, BOM v1.3.xlsx, HBridge.kicad_sch, HalfBridge.kicad_sch, Mcu.kicad_sch, Misc.kicad_sch, PowerInput.kicad_sch, PowerSources.kicad_sch]
2020-10-29 v1.3 Layout added & schematic update.
    [HalfBridge.kicad_sch, Mcu.kicad_sch, Misc.kicad_sch, PowerSources.kicad_sch, WaveUltrasonics.kicad_pcb, WaveUltrasonics.kicad_sch]
